3araht/bandominedoni/pictures/20210606_bandominedoni_FN_layer.png

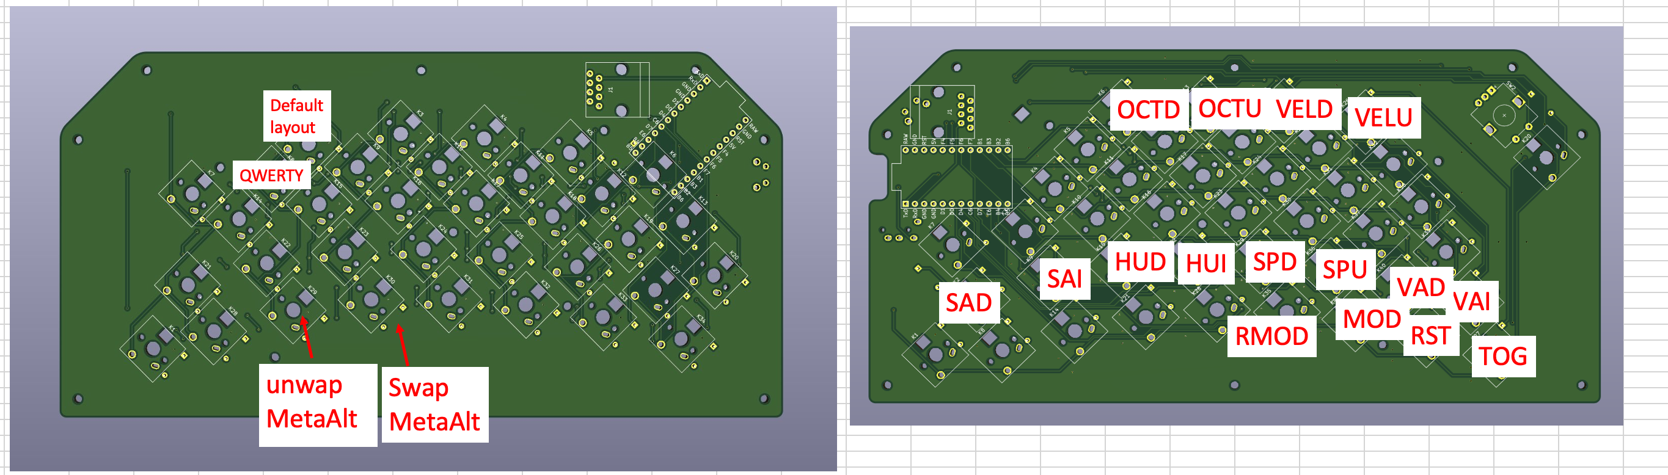
pictures/20210606_bandominedoni_FN_layer.png
