3araht/bandominedoni/pictures/keymap_cheatsheet_bandominedoni.png

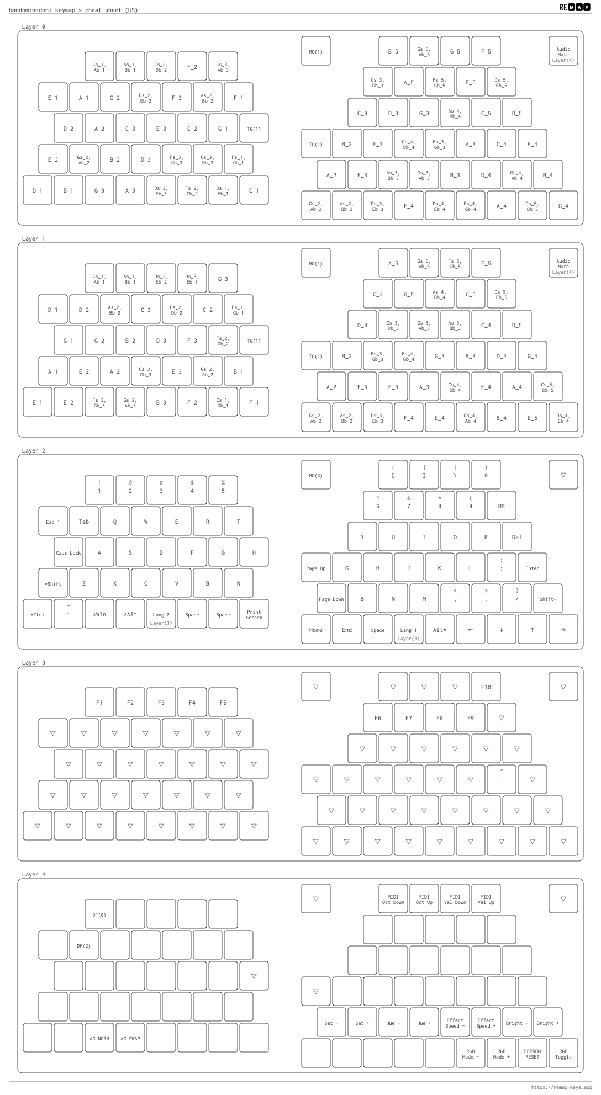
pictures/keymap_cheatsheet_bandominedoni.png
