3araht/bandominedoni/pictures/new_keyboard_bandominedoni.jpg

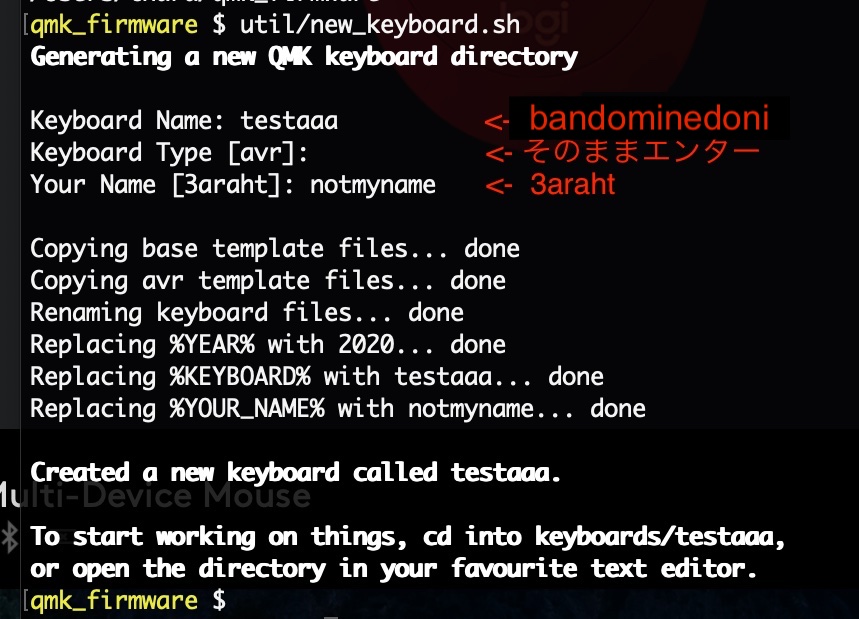
pictures/new_keyboard_bandominedoni.jpg
