3araht/bandominedoni/docs/build.md

# bandoMIneDonI Build Guide

**一度すべて読んでから組み立てることをお勧めします。**

## 0 ##
## パーツの確認、各部品の実装面の整理 ###
### キット付属品

| パーツ名 |  個数  |  備考  |
|---|---|---|
|基板|2枚||
|ボトムプレート|2枚||
|M2 スペーサー |26個||
|M2 ネジ|52個||
|クッションシール|10個||
|リセットスイッチ|2個|ファームウェアを書き込むときに使います。|
|ダイオード 1N4148|76個|左手側 33鍵 + 1鍵 + 右手側38鍵 + 2鍵 + 2（開閉ペダル用＋機能切り替えボタン用 )|
|TRRS コネクタ|1個|開閉ペダル接続用|
|LAN コネクタ|2個|左右キーボード接続用|

### 別途用意いただく必要のあるもの

| パーツ名 |  個数  |  備考  |
|---|---|---|
|[Pro Micro （コンスルー付き）](https://yushakobo.jp/shop/promicro-spring-pinheader/)|2個|ファームウェア なし をお選びください（別途書き込みます）。|
|Kailh mid-height スイッチ|71 〜75個|Cherry MX系は使えません！！！|
|13 mm 角のキーキャップ|71〜75個|（Cherry MXと同じステムなのですが、普通の1Uサイズのキーキャップは隣接するキーキャップと干渉してしまうため、使えません！！！）デモ機では、nekoka さんの「OYKキーキャップ1Ux80個(MidHeightスイッチ 13x13mmキーピッチ用)　https://make.dmm.com/item/1317194/ 」を使っています。|
|MicroUSBケーブル|1本|Pro Micro 側のコネクタの耐久性が低いためマグネット式を推奨。Pro Micro にファームウェア書き込むときにとても便利です。また、データ通信ができるケーブルである必要がありますので、充電用のケーブルは使えません。Hex ファイルが書き込みできなかったらケーブルを確認してみてください。|
|LANケーブル|1本|左右のキーボード接続用に使います。細身タイプがおすすめ。|

### [Optional]別途用意いただく必要のあるもの

| パーツ名 |  個数  |  備考  |
|---|---|---|
|LED: SK6812mini-E|1個 or 76個|内訳：開閉ペダル用 1 個だけ光らせる場合、もしくは、全てのLEDを光らせる場合は上に加えて音階キー33 + 38 個+追加ボタン（左側1個＋右側2個。LEDのデータ伝送の都合上、追加ボタンを使わない場合でも実装する必要があります）+ 機能切り替えボタン 1 個|
|[ロータリーエンコーダ(ノブ付き)](https://yushakobo.jp/shop/pec12r-4222f-s0024/)|1個|[押しボタンがないタイプ](https://akizukidenshi.com/catalog/goods/search.aspx?search=x&keyword=EC12E24)の場合、ロータリーエンコーダーの下にキースイッチを付けることで、押しボタン機能部分の代用が可能です。ロータリーエンコーダーがなくても、このキースイッチを付けることでミュートON/OFF、長押しでモード切り替えが可能です。なお、実装可能なロータリーエンコーダーは EC11 EC12 の2タイプです。|
|サスティンペダル|1台|サスティンペダルを使わなかった場合を想定し、その時をOpen状態（蛇腹を広げた時の状態）にするため、デフォルトはノーマリオフタイプ（KORG）を想定しています。ソースを1行書き換えることでノーマリーオンタイプ（主にYAMAHA、ROLAND）にも対応します。 極性切り替えタイプのペダルもあるのでそちらをおすすめします。|
|3.5 mm ミニジャック変換ケーブル|1本|サスティンペダルのモノラルジャックを TRRS コネクタに刺さるように変換します。|

### オモテ面、裏面の実装物

**※ 部品の実装には順番があります。特に、Pro Micro、キースイッチ、エンコーダ、の実装は最後になりますので先に実装しないよう注意ください。
実装の順番はこの後の手順に従ってください。**

右手側 オモテ面<br>
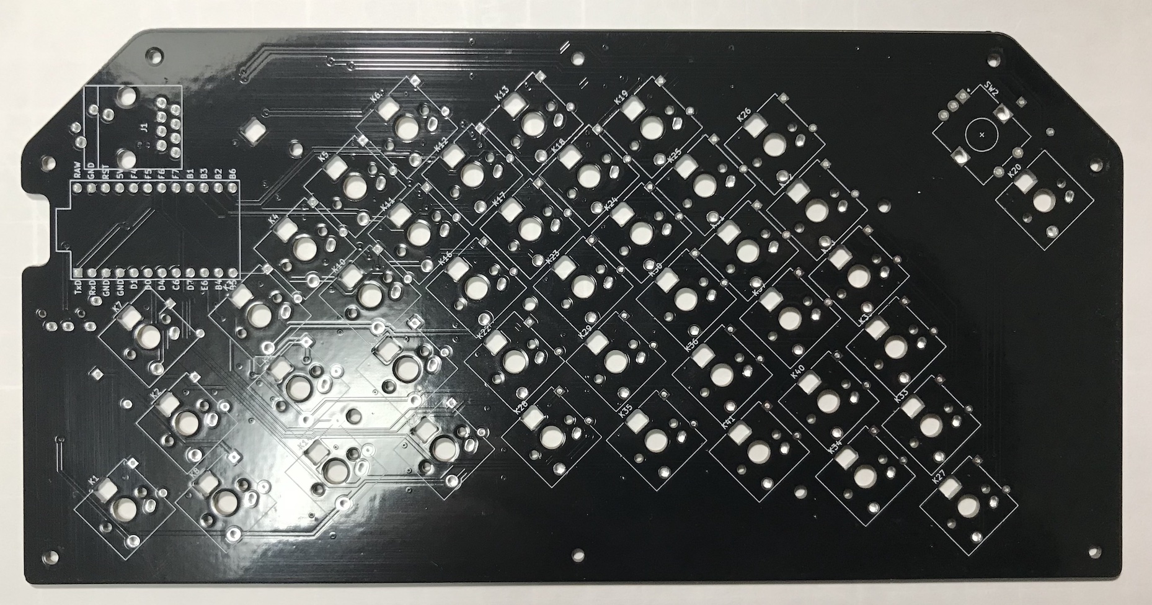
[picture p6: pictures/right_pcb_front_r02.jpg]


右手側 裏面<br>
基板の裏面には、ダイオードの実装場所やキーボード名が印字されています。<br>
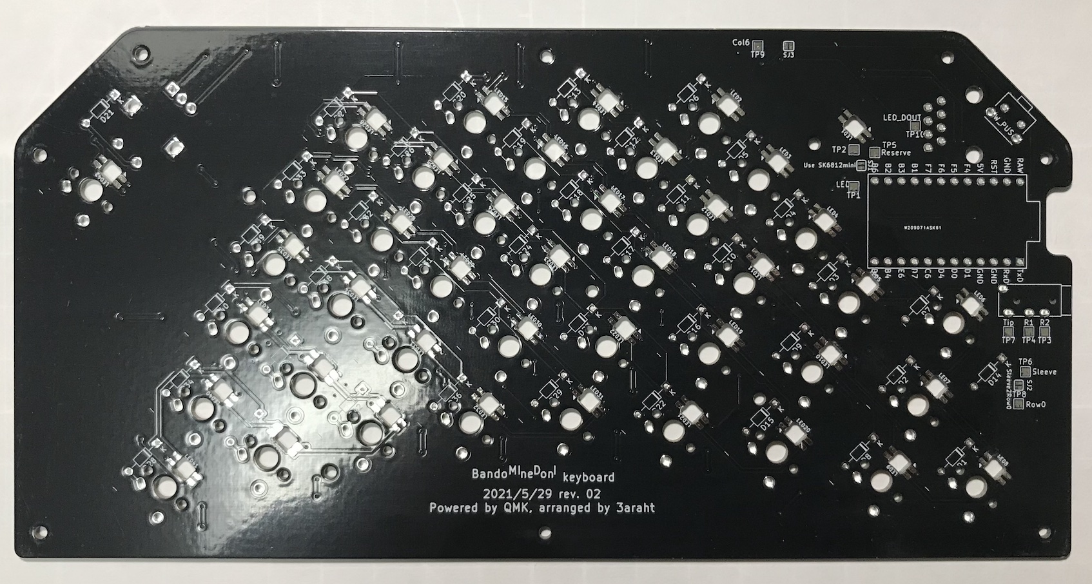
[picture p7: pictures/right_pcb_rear_r02.jpg]


左手側 オモテ面<br>
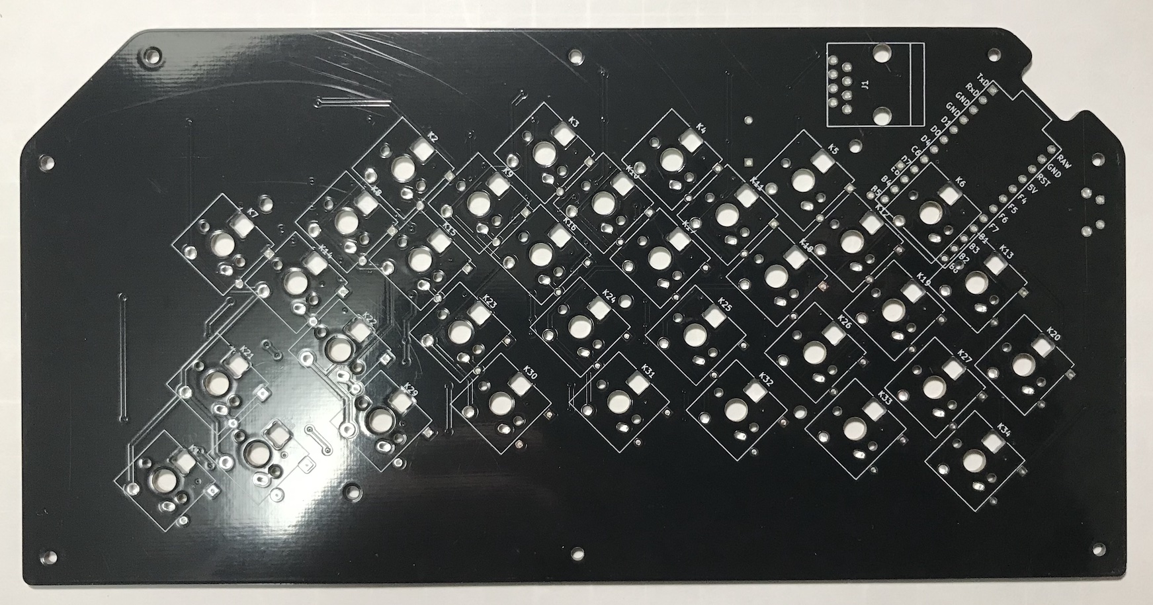
[picture p8: pictures/left_pcb_front_r01.jpg]


左手側 裏面<br>
基板の裏面には、ダイオードの実装場所やキーボード名が印字されています。<br>
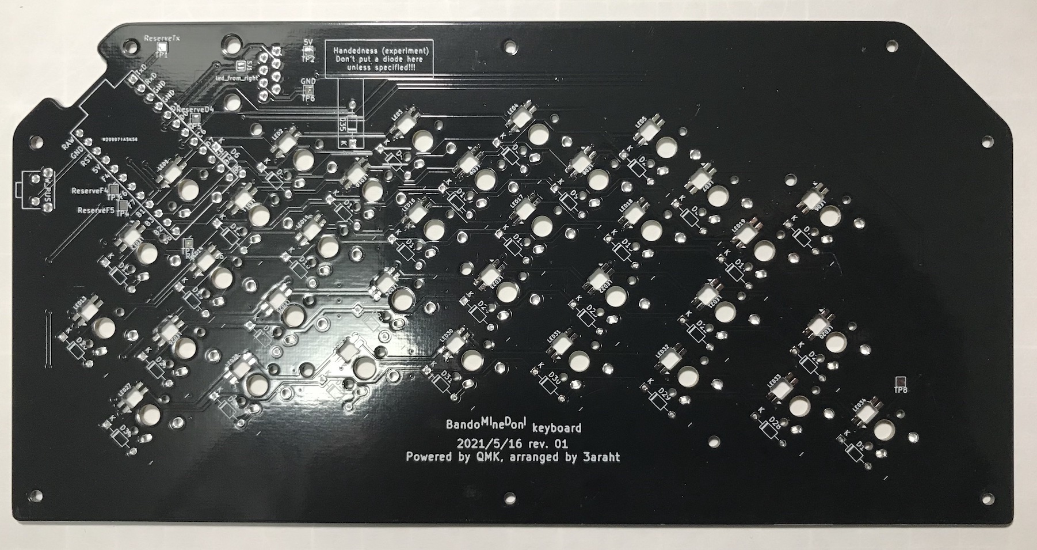
[picture p9: pictures/left_pcb_rear_r01.jpg]


#### 裏面には次の部品を実装します
 - ダイオード
 - リセットスイッチ
 - Pro Micro
 - TRRS コネクタ
 - LED[Optional]

#### オモテ面には次の部品を実装します
 - キースイッチ
 - LAN コネクタ
 - エンコーダ

## 1
## ダイオードの取付け ##
キーの数が多いキーボードではMatrixという手法を使ってキーが押されたかどうか判断します。
キーが必ず1個ずつしか押されないと保証されているのであれば、このダイオードは不要なのですが、
和音を弾くことがあるので複数のキーを同時に押す場面が出てきます。
このとき、Matrixという手法で複数同時押しを正しく判断するためにこのダイオードが必要になります。
詳しい説明については、[こちら](https://docs.qmk.fm/#/how_a_matrix_works)などをご覧ください。

ダイオードには向きがあります。また、図のように足を曲げておきます。
ダイオードをつまんで両端の足を同時に曲げると図の右のように比較的ちょうどいい形になります。<br>
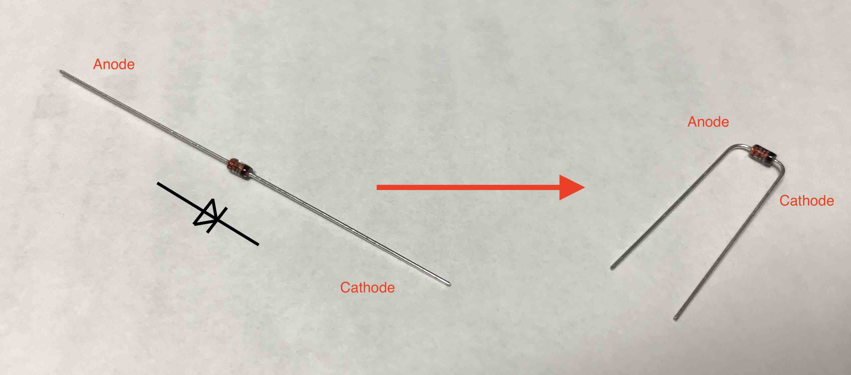
[picture p10: pictures/diode_bend.jpg]
diode


キースイッチと干渉しないように、ダイオードは基板の裏面に実装します。
ダイオードの黒い線のほうが四角いフットプリント（Kと印字されている方, K はKathode（独）の頭文字らしいですが、黒（Kuro) の K で。）に合うように配置します。<br>
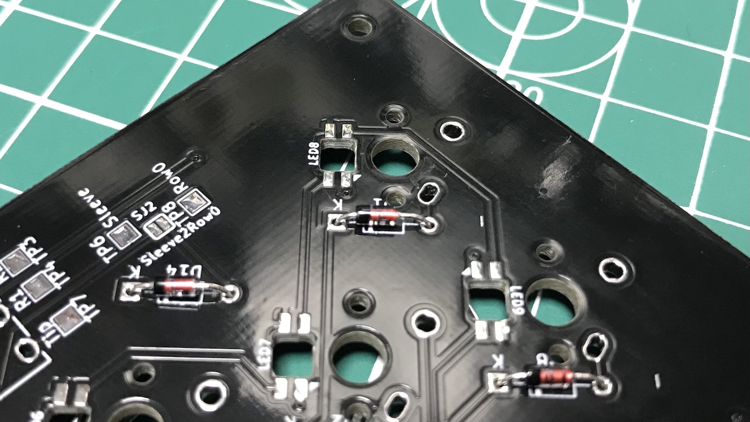
[picture p11: pictures/diode_align.jpg]
diode


足を曲げて基板に這わせてダイオードを仮止めします。<br>
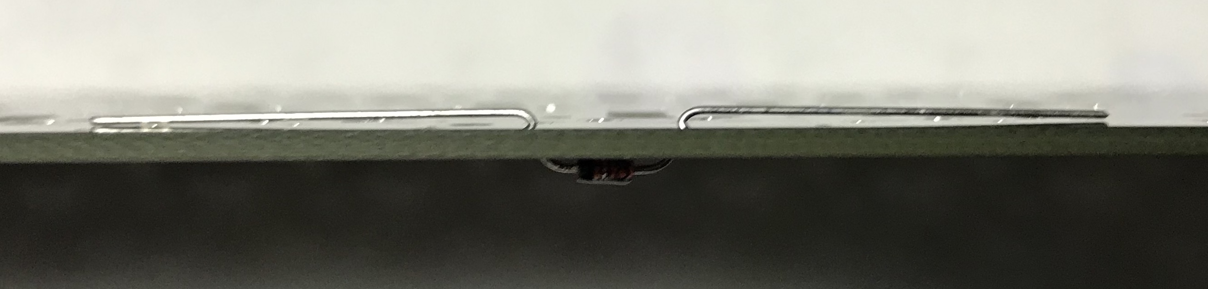
[picture p12: pictures/diode_flatten.jpg]
diode


オモテ面から見た図<br>
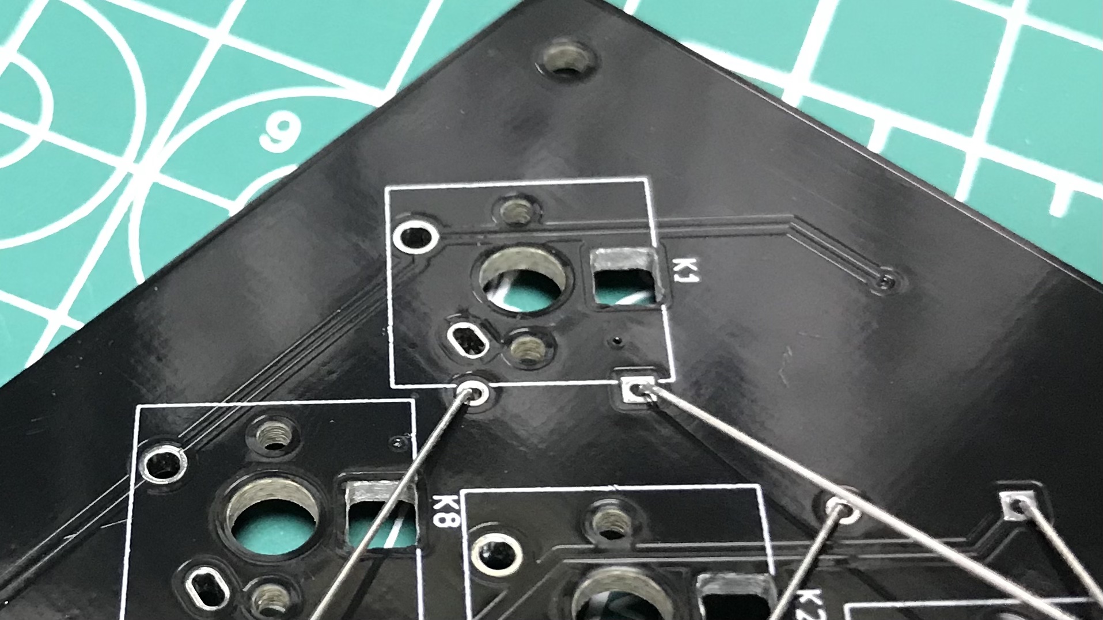
[picture p13: pictures/diode_flatten2.jpg]
diode


オモテ面から半田付けします(あ、ピンボケ。。。)。<br>
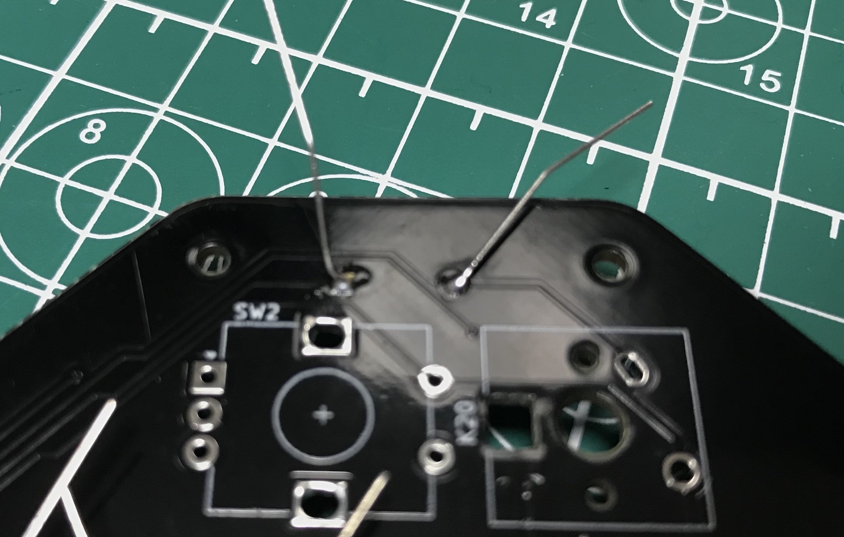
[picture p14: pictures/diode_soldered.jpg]
diode


足をニッパでカットします。足は勢いよく飛んで行くので、足を押さえながら切ると良いです。<br>
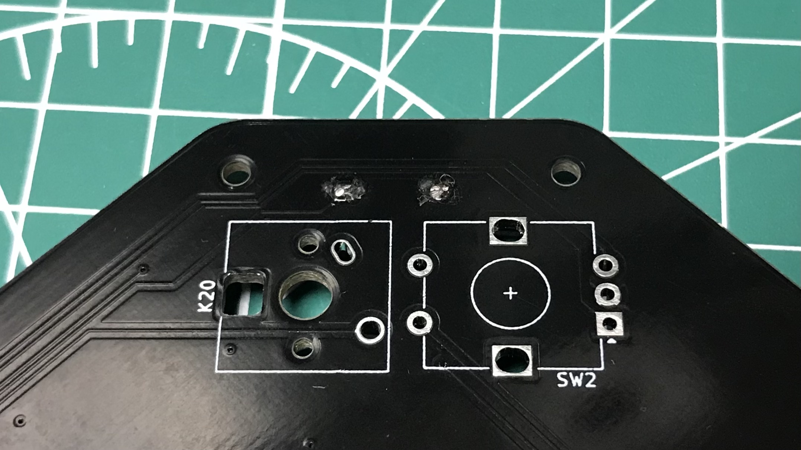
[picture p15: pictures/diode_feet_cut.jpg]
diode


これを右手側は D01 〜 D42 の42箇所、左手側は D01 〜 D34 の34箇所、半田付けします。<br>

~~左手側基板の D35 にもダイオードを実装します。このダイオードは、右手側基板か左手側基板かを Pro Micro が判断するのに用います。~~<br>
ケーブルをゆっくり接続する分にはよかったのですが、素早く抜き差しをすると、右手側基板が間違って左手側と誤認識することがしばしば発生しました。そのため、この機能を使うのはやめました。MASTER_RIGHT を定義したので、USBケーブルが刺さっている方を右手側基板と認識します。<br>
⇨ 左手基板の D35 は実装不要です。<br>
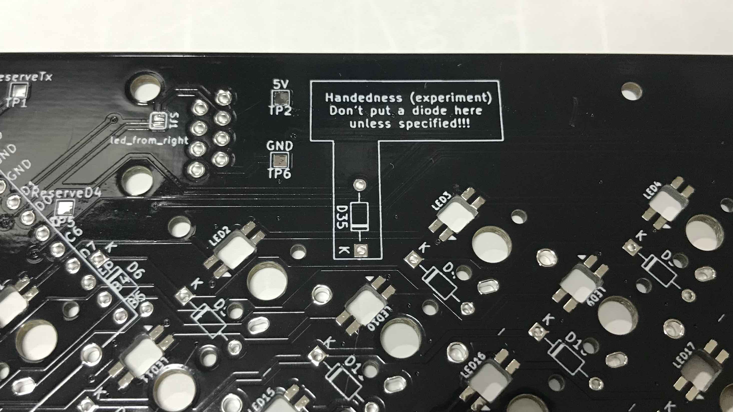
[picture p16: pictures/handedness.jpg]


## 2 ##
## リセットスイッチ、TRRS コネクタの取り付け ##
白い四角い枠のシルクに沿って裏側に取り付けます。浮いたり曲がった状態で実装しないようにマスキングテープなどで予め仮止めしてから半田付けするとミスが少なくなります。<br>

TRRS コネクタを図のように実装します。<br>
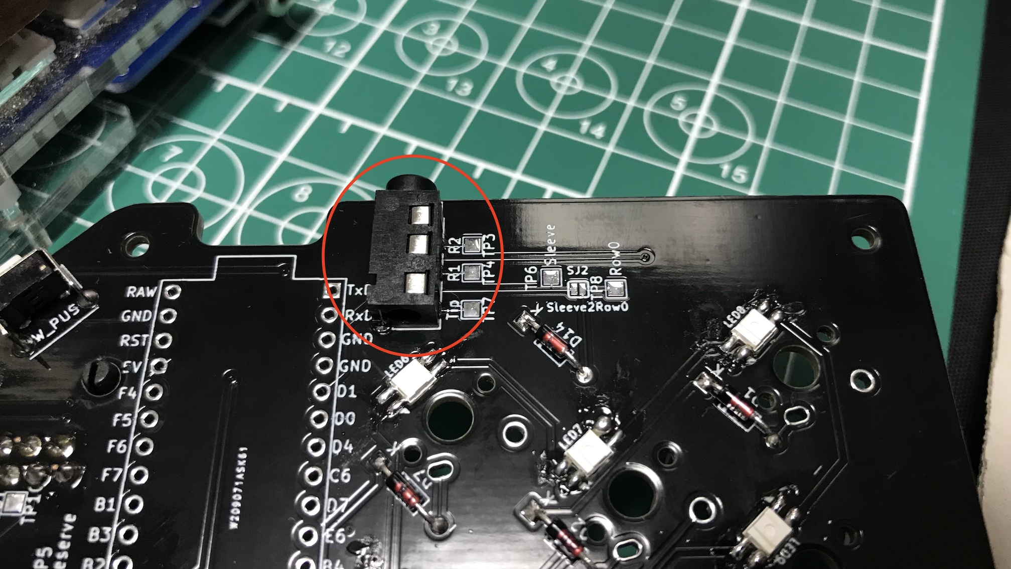
[picture p17: pictures/TRRS_RESETsw_soldering.jpg]
TRRS
<br>

また、ジャンパー2箇所に半田を盛って導通するようにします。<br>
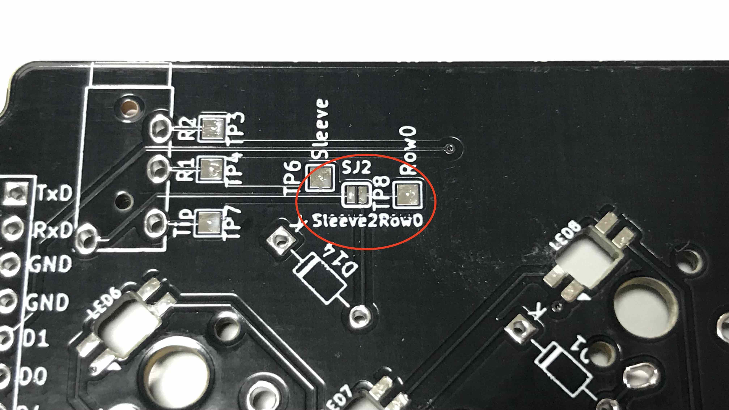
[picture p18: pictures/right_jumper_SJ2.jpg]
<br>
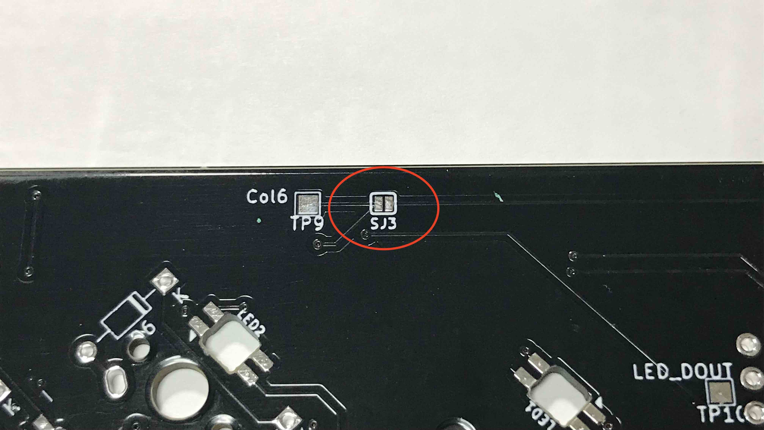
[picture p19: pictures/right_jumper_SJ3.jpg]
<br>

右手側のリセットボタンの足が、あとで実装する LAN コネクタと干渉するため、リセットボタンの足を切ってから半田付けします。<br>
※ rev.04 の基板ではこの問題は解消していますので、3、へ進んでください。<br>

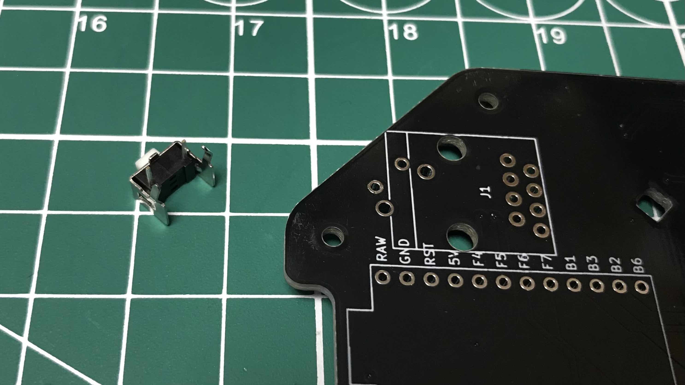
[picture p20: pictures/RESETsw_soldering_right1.jpg]
ResetSW
<br>
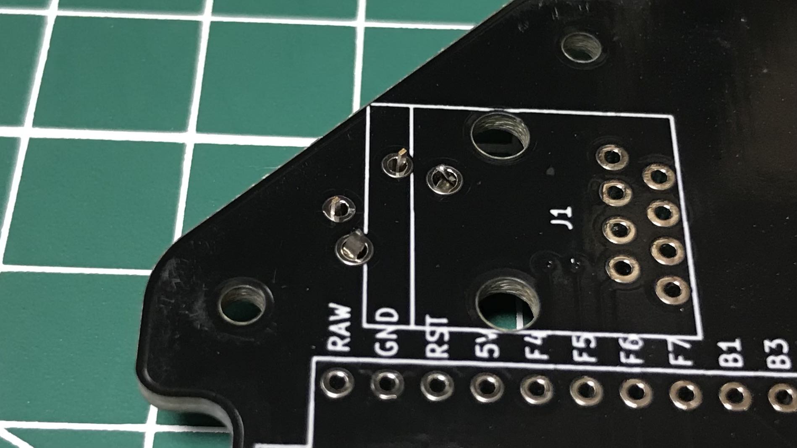
[picture p21: pictures/RESETsw_soldering_right2.jpg]
ResetSW
<br>
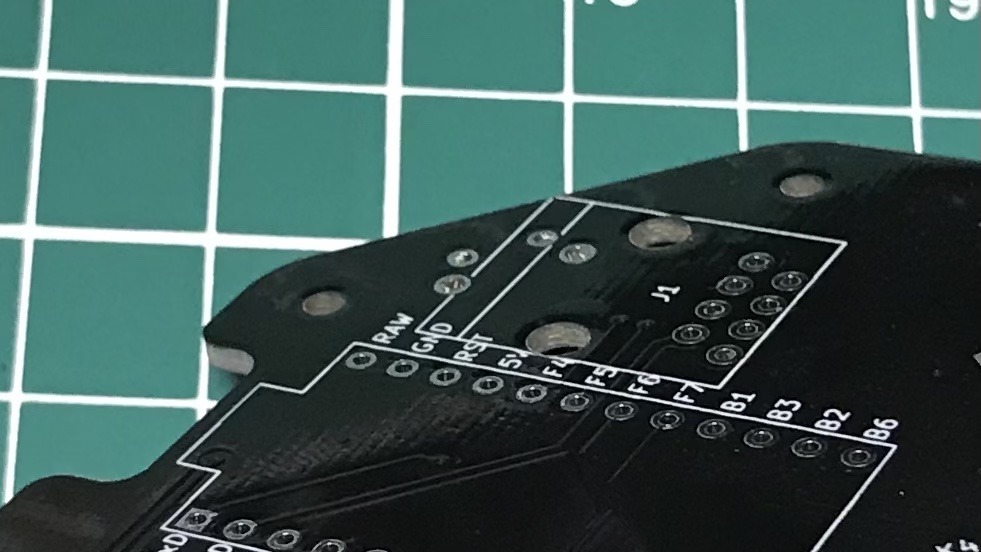
[picture p22: pictures/RESETsw_soldering_right3.jpg]
ResetSW
<br>

左手側基板のリセットスイッチも裏面に実装します。
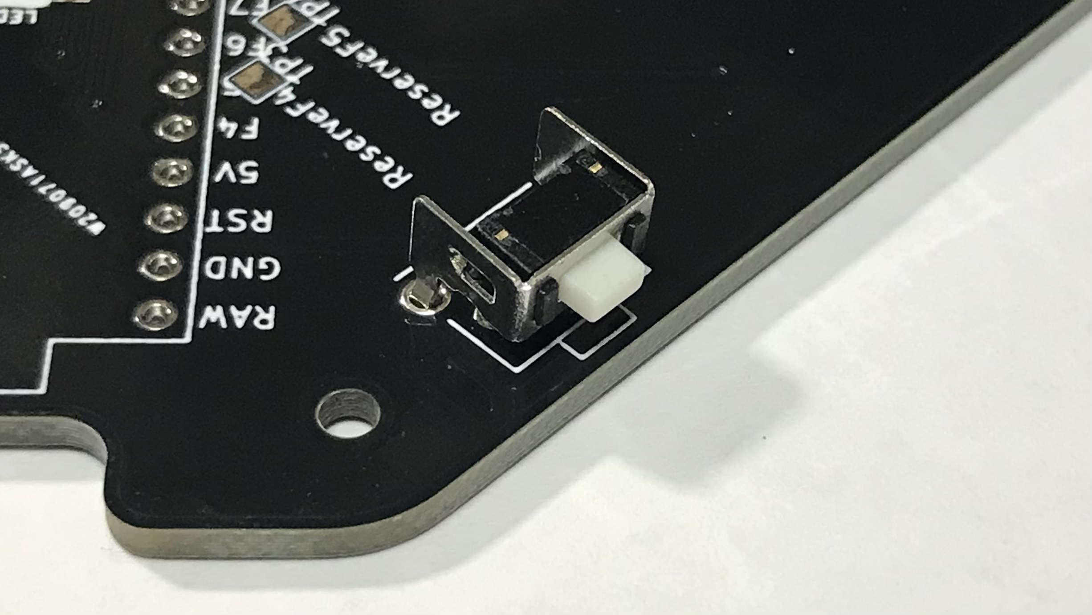
[picture p23: pictures/RESETsw_soldering_left.jpg]
ResetSW
<br>

## 3 ##
## LANコネクタの取付け ##
左右の基板のオモテ面にそれぞれLANコネクタを実装します。<br>
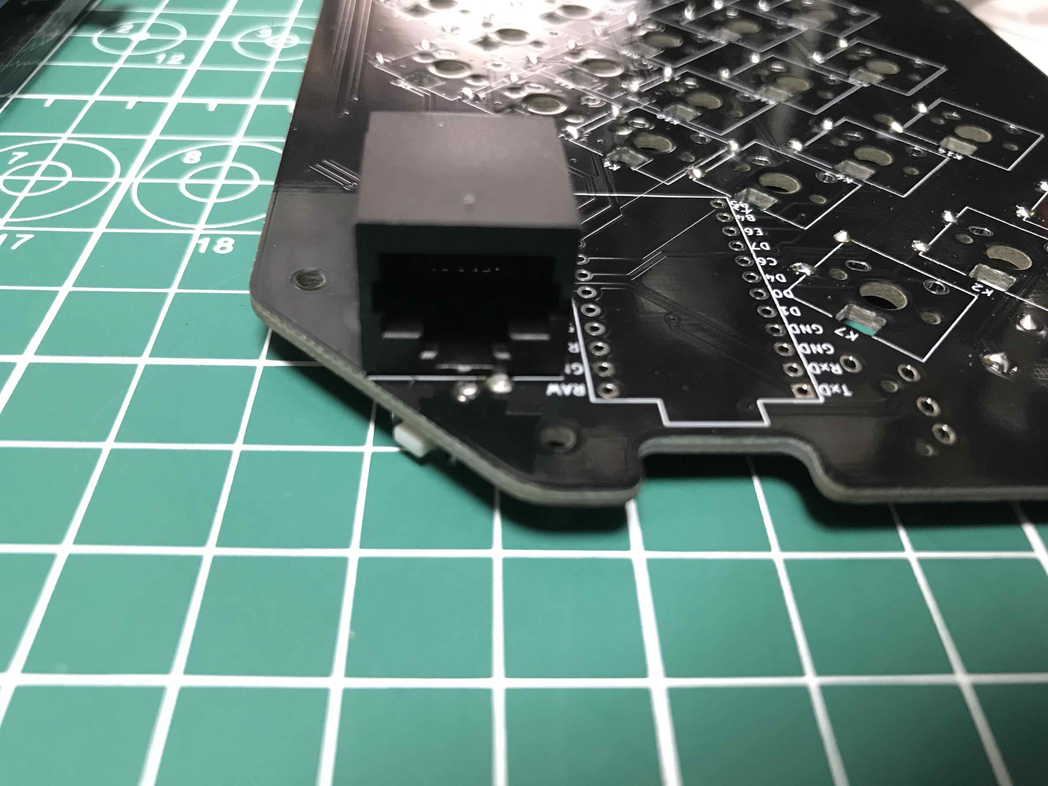
[picture p24: pictures/LAN_connector.jpg]
<br>

## 4 ##
## Pro Micro の仮り取付け ##
**ここでは Pro Micro をコンスルー（別名 スプリングピンヘッダー ＝ Pro Micro を基板から着脱可能にするコネクタ）を使うことを前提とし、コンスルーと Pro Micro を半田付けして Pro Micro にファームウェアを書き込みます。あとで Pro Micro を取り外す必要がありますので、（おすすめしませんが）コンスルーを使われない方はキースイッチ実装したあとでProMicroを実装してください。**

※コンスルーを使う場合は Pro Micro 側のみを半田付けします。<br>
コンスルーの役割： 基板側を半田付けしないことにより、 Pro Micro を基板から外せるようにします。
これにより、万が一 Pro Micro の microUSB コネクタがもげても交換が容易になります。<br>

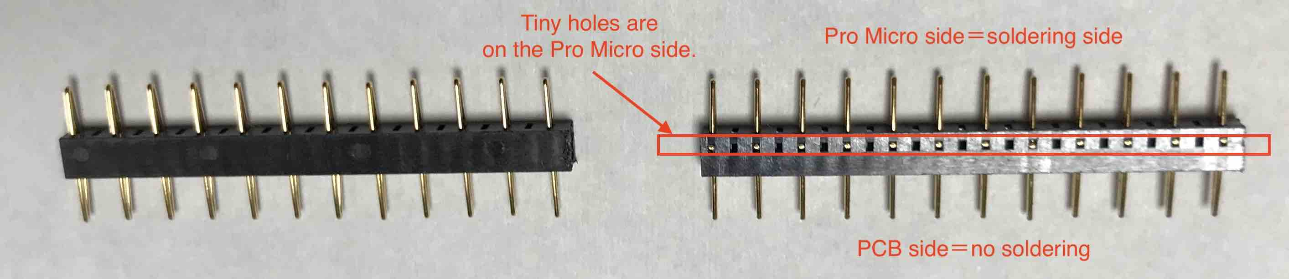
[picture p25: pictures/Con_through.jpg]


コンスルーを斜めに半田付けしないように、基板の**裏面から**コンスルーを差しておいてピンが垂直になるようにします。
下図のように、Pro Micro 側(側面に空いている小さな穴が近い方)を上にして基板にコンスルーを差し込みます。
このとき、図のように、コンスルーの向きを揃えておきます（＝2つとも側面の小さな穴が空いている方向を揃えます）。<br>
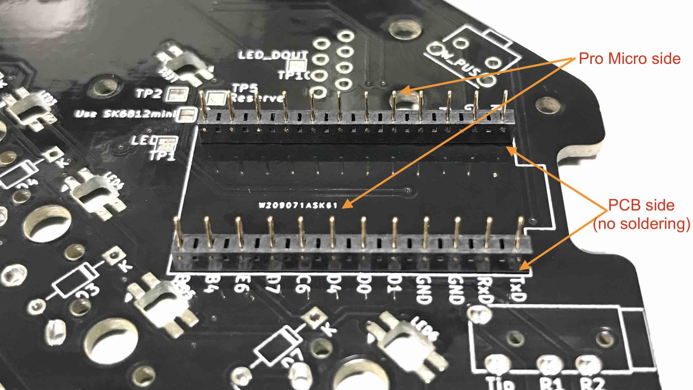
[picture p26: pictures/Con_through_onPCB.jpg]


*Pro Micro の上下の向きに注意。Pro Micro の TxD ピンが基板の TxD に刺さるように向きが合っているか確認します。<br>
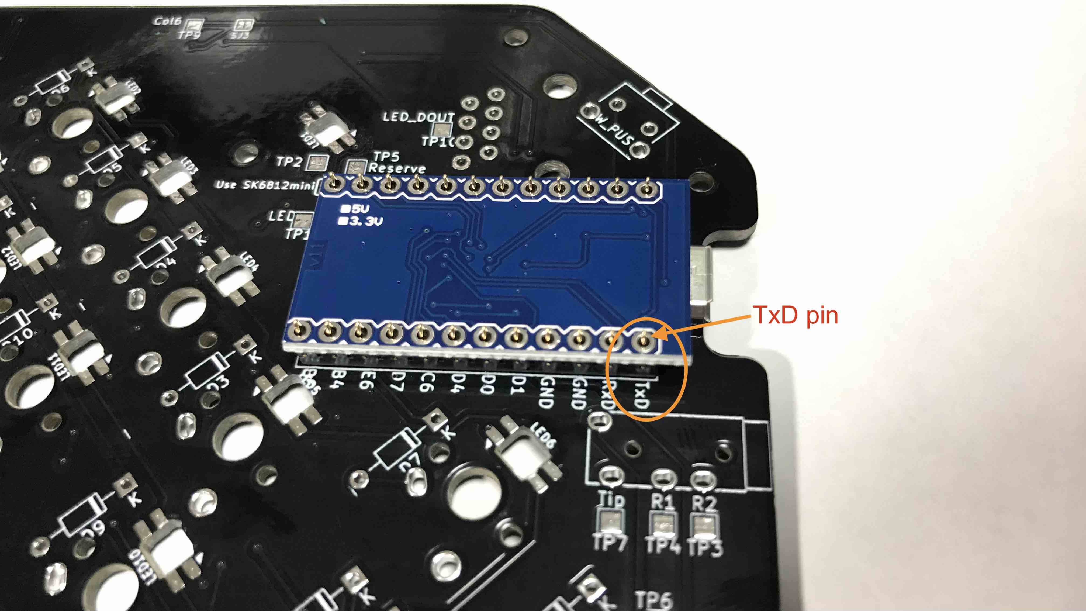
[picture p27: pictures/ProMicroPinAlignment.jpg]
<br>

コンスルーを基板の裏面から差し、TxD の位置を見て向きが揃っていることを確認したら、コンスルーと Pro Micro を半田付けします。<br>
**Pro Micro が浮きやすいので、Pro Micro をしっかり押さえながら最初に四隅を半田付けすると作業が楽になります。**<br>
**一度半田付けしたコンスルーを外すのは困難を極めますので、十分注意してください。**

コンスルーを Pro Micro に実装した様子<br>
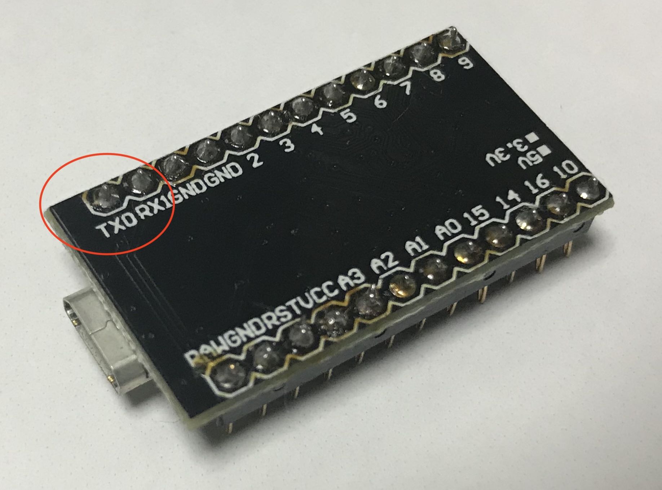
[picture p28: pictures/ProMicro_TxD_r02.jpg]
<br>
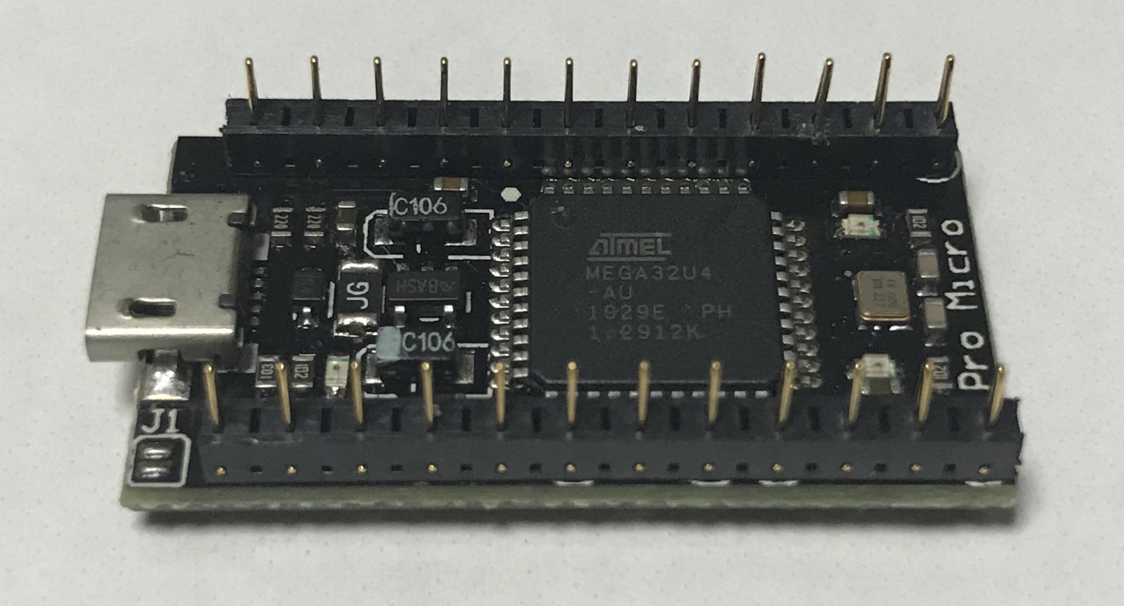
[picture p29: pictures/ProMicro_front_r02.jpg]
<br>

### (2021/06/27 追記) ProMicro を基板に実装する際に、コネクタ部を絶縁します。

これは、コネクタ部が基板と当たり、使っているうちに擦れて基板のレジストに穴が空き、そこからショートしてしまった場合に電源が入らなくなる、という問題を回避するためです( chromatonemini で発生しました)。<br>
（下に紹介する写真は chromatonemini のものになります。ご了承ください。）<br>
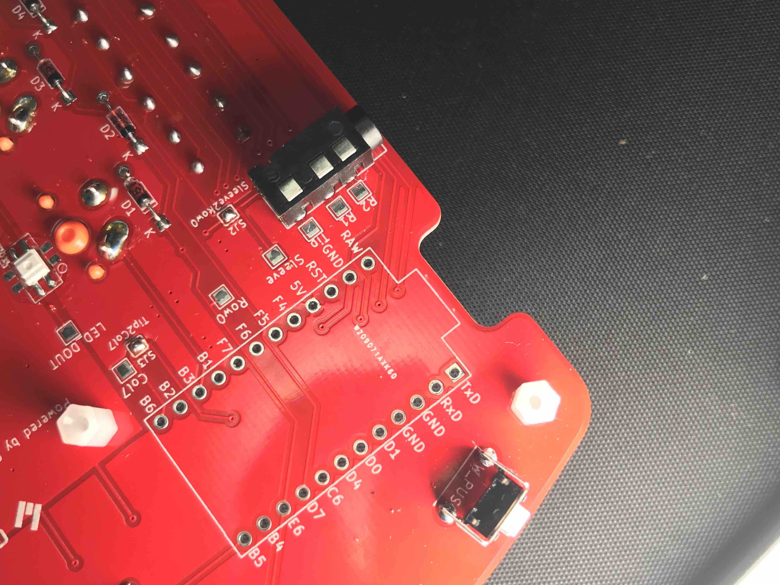
[picture p30: pictures/SnakeBite_failure.jpg]
SnakeBite
<br>

このように、スネークバイトのような跡がつき、そこからProMicro のコネクタと基板の 5V がショートしてしまっていました。<br>
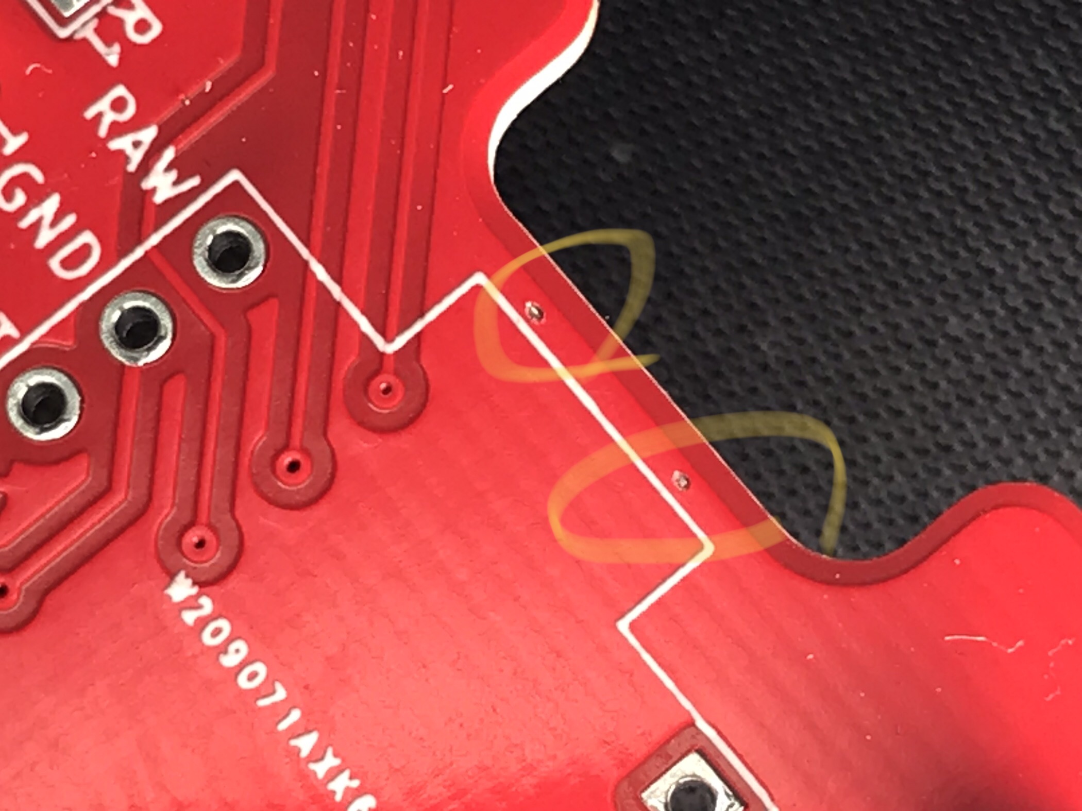
[picture p31: pictures/SnakeBite.jpg]
SnakeBite
<br>

基板にカプトンテープを貼って絶縁します。<br>
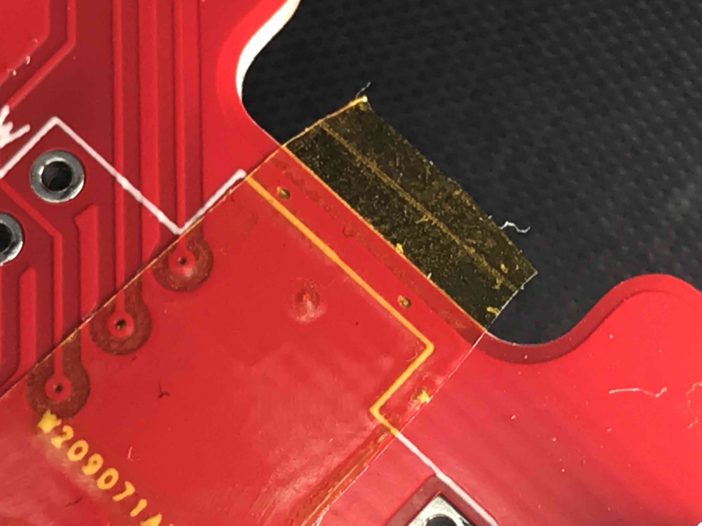
[picture p32: pictures/SnakeBiteInsulated.jpg]
SnakeBite
<br>

ProMicro の方にもカプトンテープを貼って絶縁します。<br>
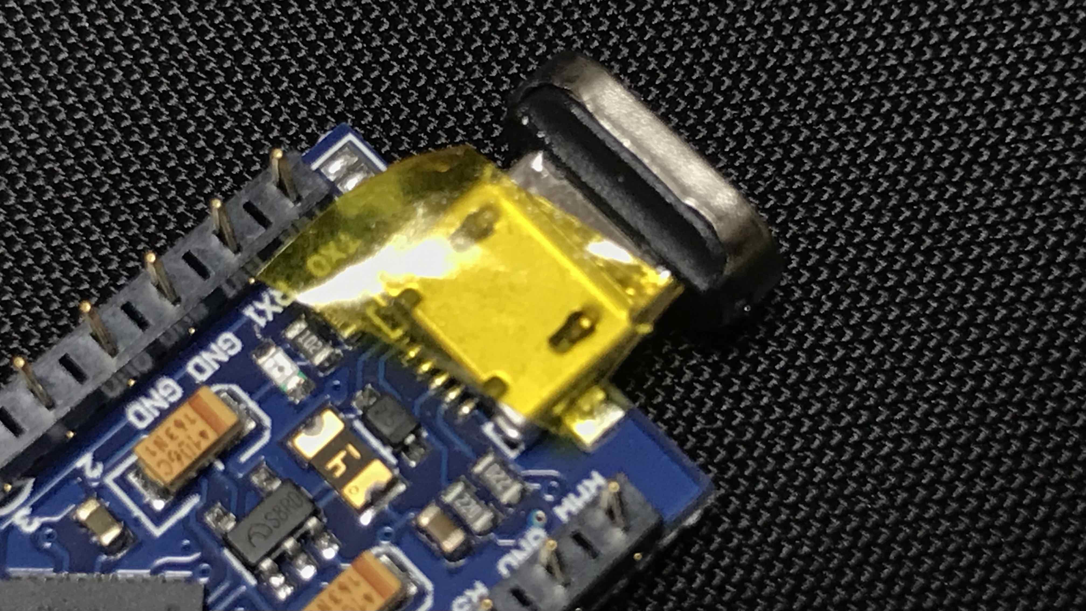
[picture p33: pictures/ProMicroInsulated.jpg]
<br>

## 5 ##
## Firmwareの書き込み ##
とりあえず動作確認用にファームを書き込みます。
LEDが光るHEXファイル(bandominedoni_led.hex)を使います。<br>

Remap を使うととても簡単に Promicro にファームウェアを書き込むことが可能です。

Remap Catalog から、 bandominedoni キーボードを探します。<br>
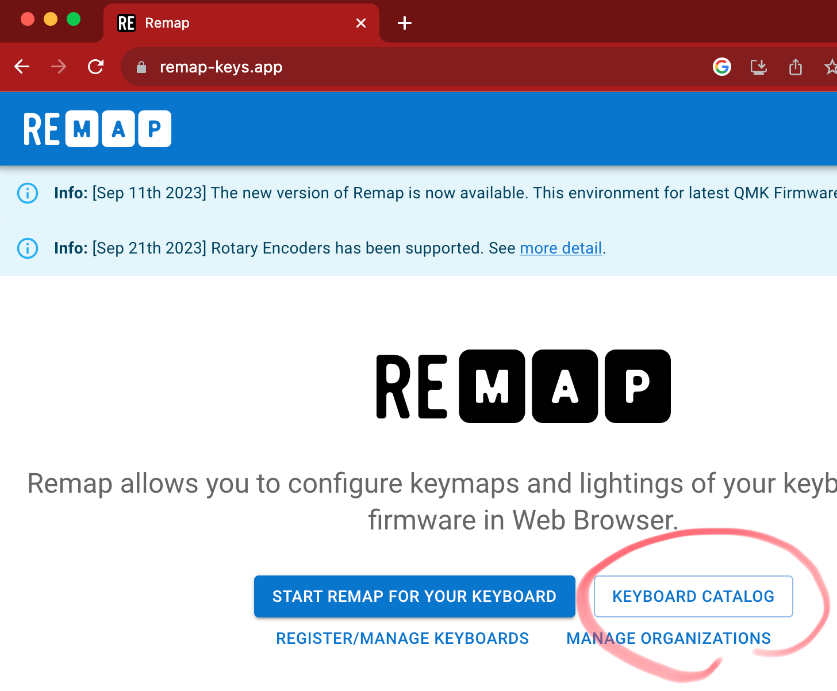
[picture p34: pictures/RemapKeyboardCatalog.png]
RemapKeyboardCatalog
<br>

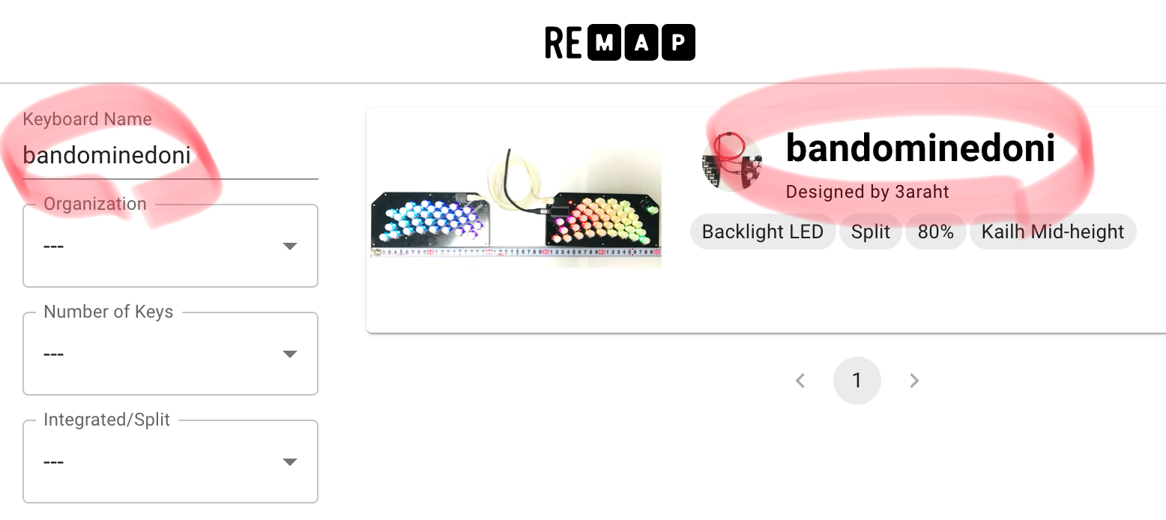
[picture p35: pictures/Remap_bandominedoni.png]
Remap_bandominedoni
<br>

書き込むファームウェアを選択します。<br>
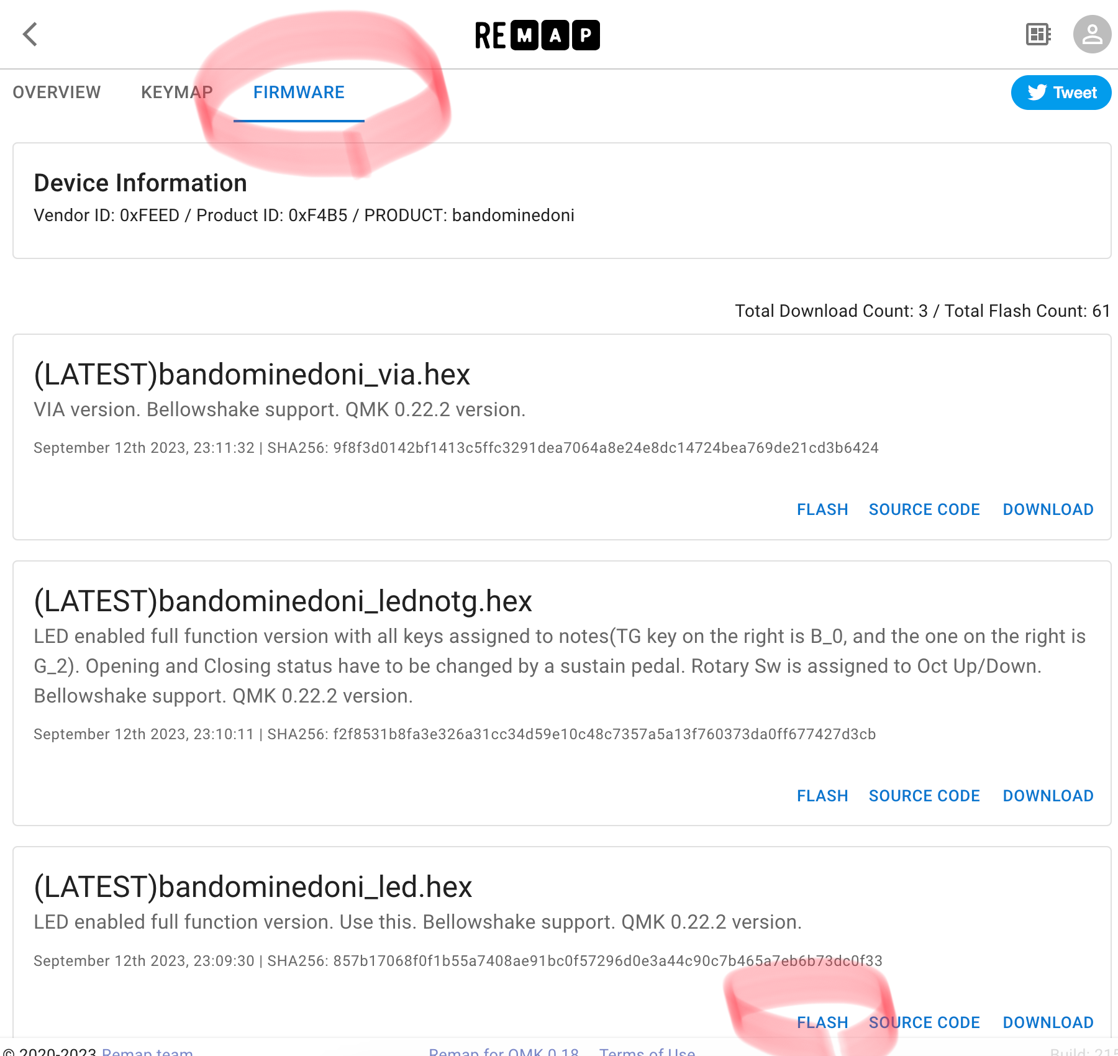
[picture p36: pictures/RemapFirmwareSelect.png]
RemapFirmwareSelect
<br>

Elite-C をお使いの場合は bootloader として dfu を、それ以外の場合は caterina を選択してファームウェアを書き込みます。書き込み方の詳細は画面に示されている手順に従ってください。<br>
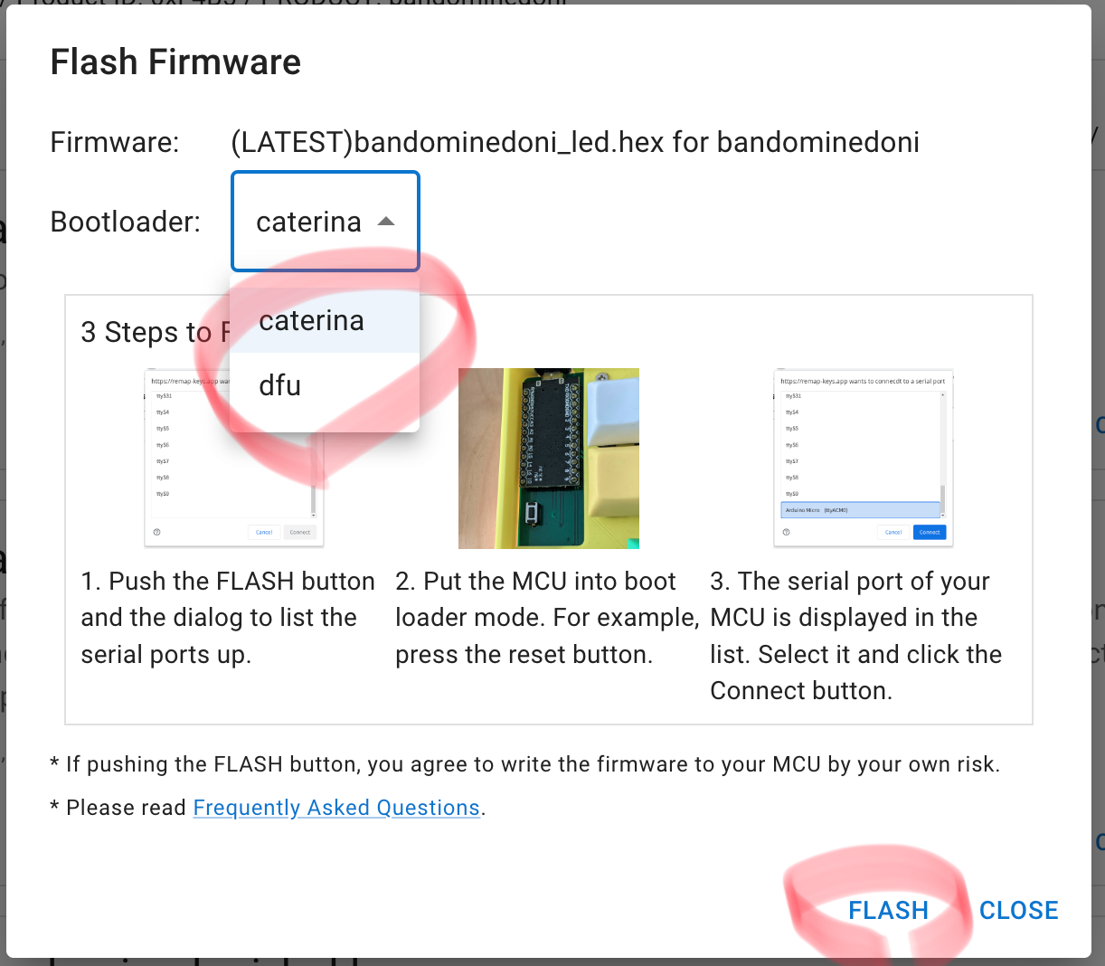
[picture p37: pictures/RemapFlash.png]
RemapFlash
<br>

他の書き込み方も色々あります。サリチル酸さんの[記事](https://salicylic-acid3.hatenablog.com/entry/qmk-toolbox)がとても参考になります(サリチル酸さん、どうもありがとうございます)。

## 6 ##
## Backlight RGB LEDの取付け[Optional] ##
以下を使うことが成功の鍵となります。<br>
- 温度調整機能付き半田ごてで温度を220℃〜250℃に設定する
- 融点の低い 鉛入り半田（共晶半田）を使う
- 電源ラインはランドが広く熱を奪われてしまうので、しっかり基板側を温める。
- 数珠繋ぎのLEDを順番に実装して光るか確認しながらすこしずつ進める。LED は 5V と GND の電源ラインに並列に実装するため、どれか1つが壊れているときにどこが壊れているかを特定するのが難しいです。⇨ 一気に全部 LED を実装しない。

バックライト用のチップ LED(SK6812mini-E) は PCB の裏面から実装します。向きに注意して穴に入れてください。
LED の裏から見て、切り欠きのある端子（GND）と基板のシルク（印字の事）の三角マークが同じ位置になります。
LED はデータを直列に伝送する都合上、行によって LED の向きが異なります。<br>
LEDの情報は直列に伝送されますので、接続が途切れてしまうと正しくLEDが光らなくなります。<br>
左手側の基板は、右手側からの電源供給およびデータ線の信号が無いと動作しませんので、左手側のLEDの動作確認をする場合にはLANケーブルを接続して、右手側の基板のPro Micro にUSBケーブルを接続してください。<br>
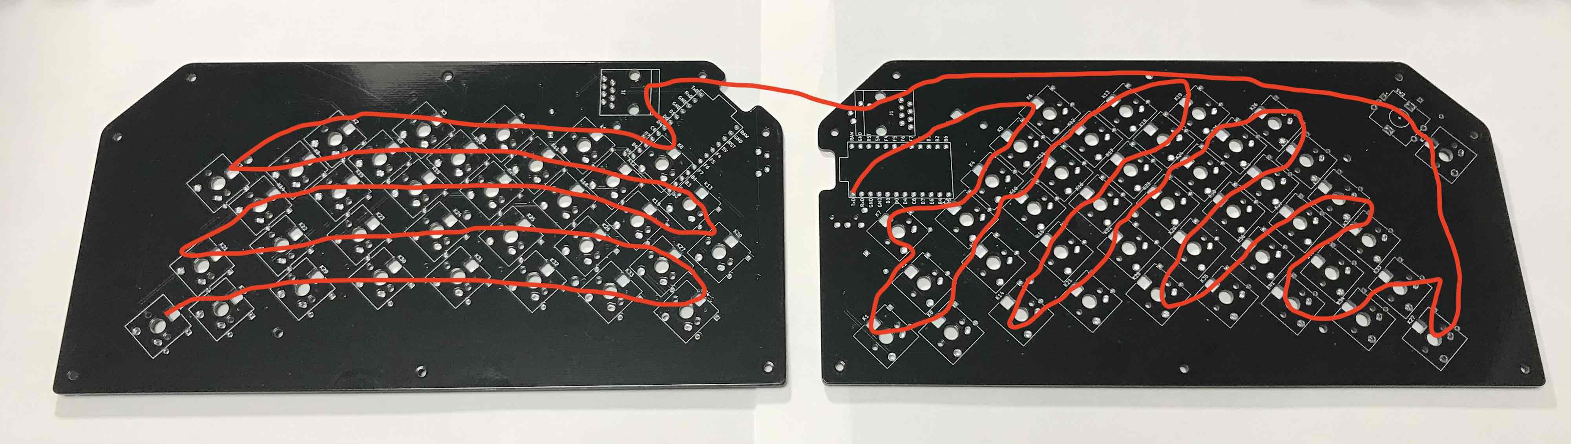
[picture p38: pictures/LED_serial.jpg]


半田付けが軌道に乗った矢先に向きを間違えがちです。
その時のショックと言ったら。。。（経験者談）。<br>
LED を穴にいれたら、端子の上に半田を盛って半田付けしていきます。このとき、基板とLEDの足の裏に半田を入れようと意識する必要はありません。基板のランドの方が LED の足よりもひとまわり大きいので、そこが半田付けされるイメージで実装していってください。<br>
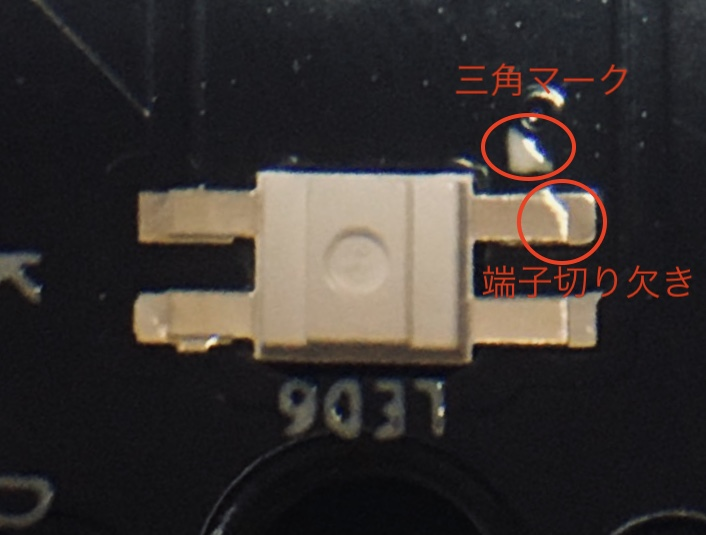
[picture p39: pictures/LED_PIN_Layout.jpg]


半田付けしてしまうと、端子の切り欠きは見えなくなります。実装後は、オモテ面から、パッケージの切り欠きをご確認ください。<br>
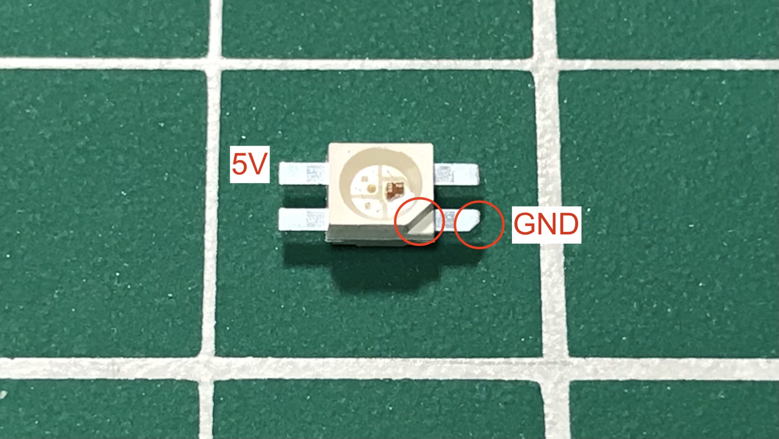
[picture p40: pictures/SK6812mini-E.jpg]


温調半田ごてを使い、約220℃ 〜 250℃ で半田付けします。温度が高いとLEDが壊れますので注意してください。
温調できない半田ごてではすぐに焦げます＆壊れます（これも経験者談）。逆に、温度調節をしていれば、LEDを熱で殺すことはほとんど無いので、ご安心ください。<br>

右手側基板の下図の位置を半田でジャンパします。<br>
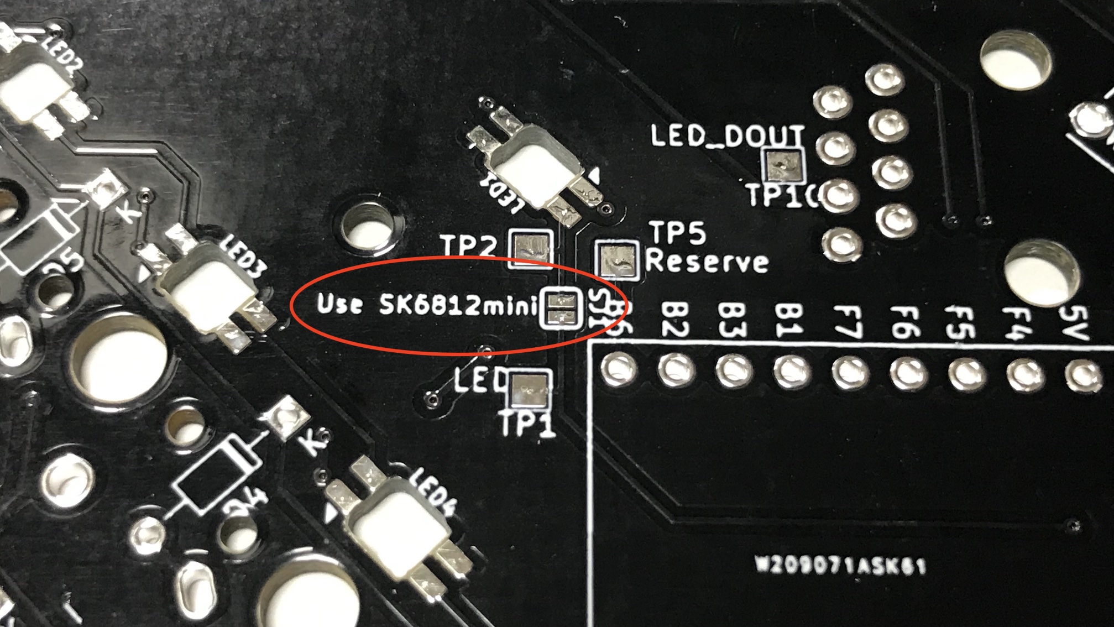
[picture p41: pictures/jumper_right_LED.jpg]
Jumper
<br>

左手側基板はここを半田でジャンパします。<br>
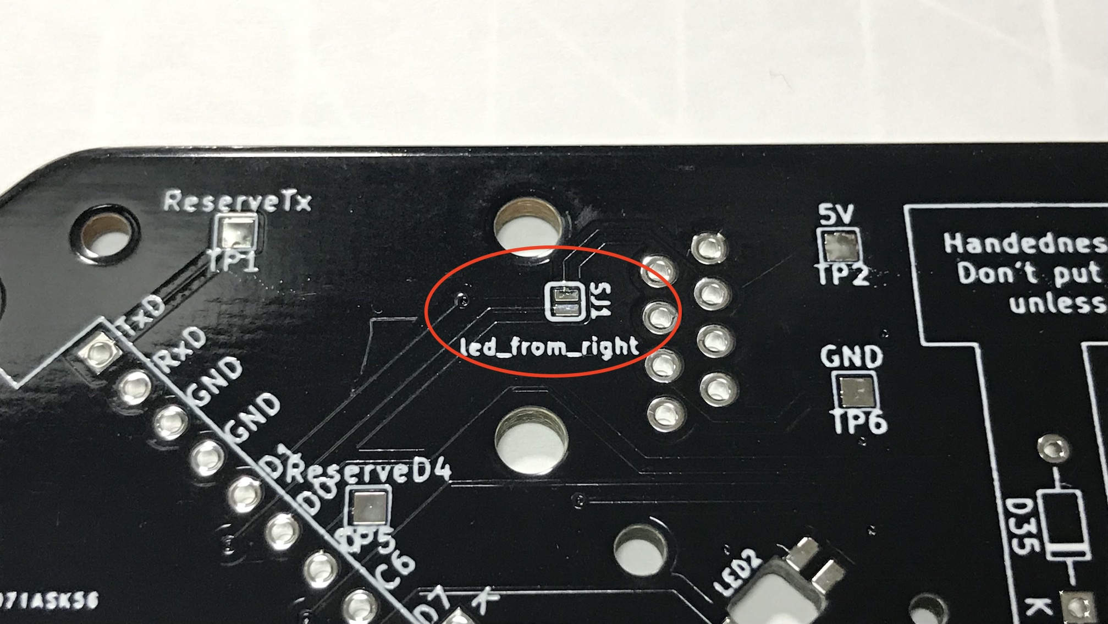
[picture p42: pictures/jumper_left_LED.jpg]
Jumper
<br>

## 7 ##
## 基板へのスペーサーのネジ止め ##
スペーサーを基板の裏面にネジで左右の基板それぞれ 13 箇所固定します（ネジをオモテ面に挿し、スペーサーが裏面にくるようにします）。<br>
キースイッチを半田付けした後にはネジを挿入することが難しい箇所があるため、キースイッチを半田付けする前に基板にネジを固定します。<br>
ただし、半田ごてがスペーサーに触れてしまうとスペーサーが溶けてしまうので、半田付けする際には十分ご注意ください。<br>

左手基板裏面<br>
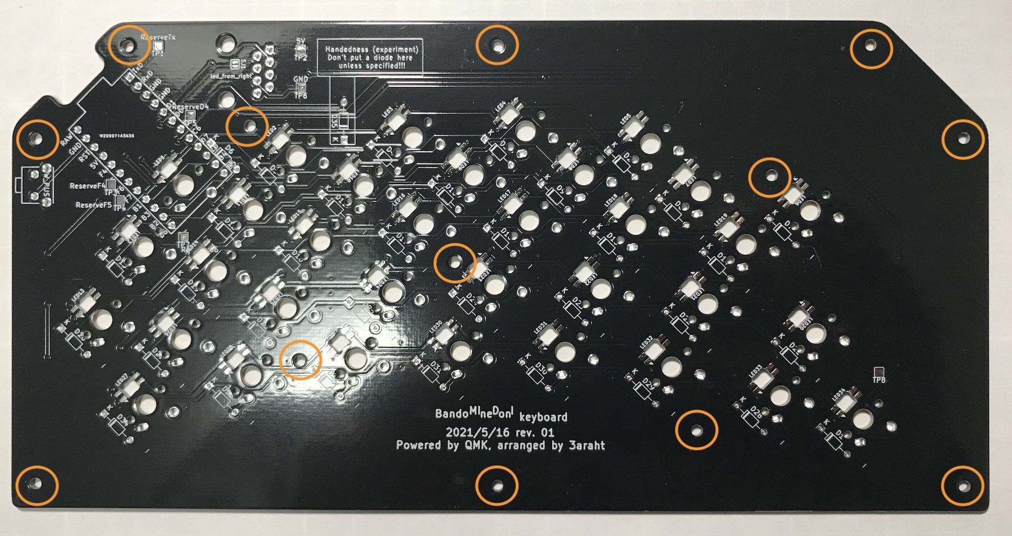
[picture p43: pictures/left_pcb_rear_r01_Spacer.jpg]
<br>

右手基板裏面<br>
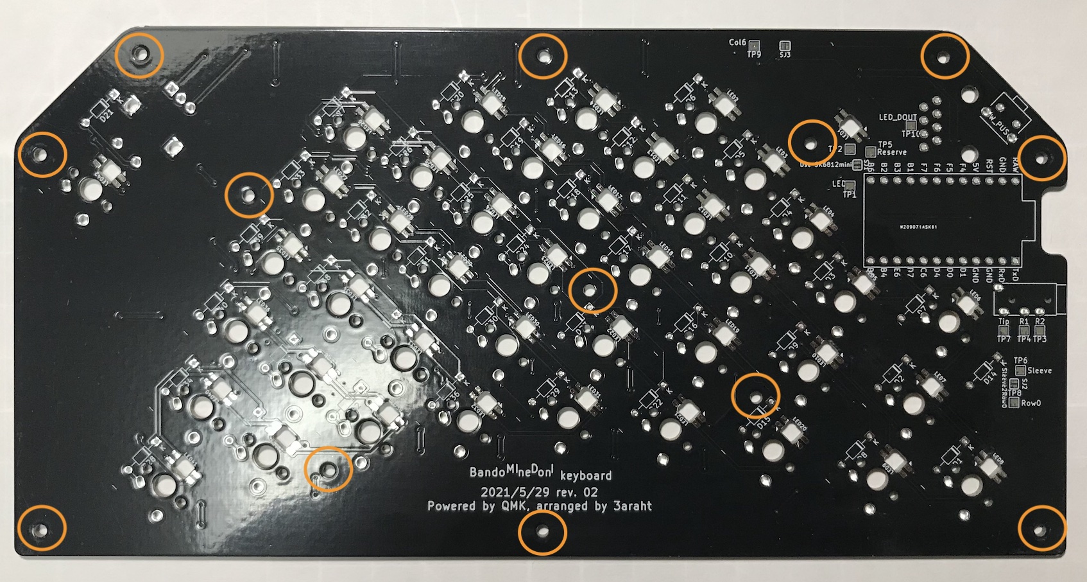
[picture p44: pictures/right_pcb_rear_r02_Spacer.jpg]
<br>

## 8 ##
## キースイッチの取付けと、エンコーダの取付け ##
**スイッチを取り付ける前に部品の取付けや半田付けができているか確認します。**<br>
（1 のダイオードは必ず済ませておいてください。）<br>

*動作確認する際には、①HEXファイル書き込み済の Pro Micro を実装し、②USBケーブルをPro Micro に挿して実施してください。**<br>
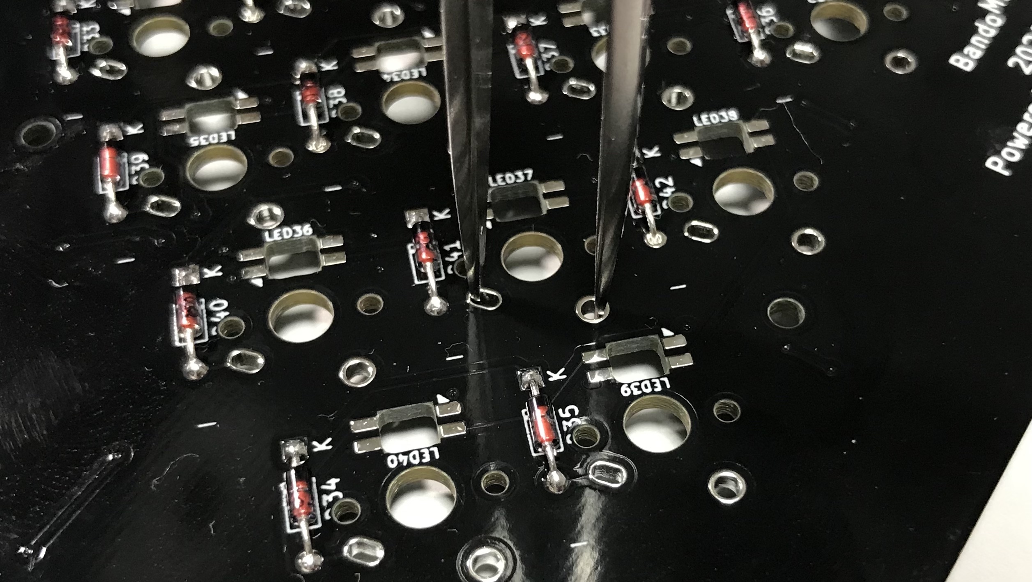
[picture p45: pictures/Keysw_test.jpg]


キースイッチをオモテ側からしっかり奥まで差し込みます。かなり固めですが、ピンが皆穴に入っていることに注意しながら押し込みます。このとき、端子が曲がっていると実装穴に端子が入らないので注意してください。1行ずつキースイッチをしっかり差し込んでから半田付けしていった方が差し込み不良は減らせると思います。<br>

ロータリーエンコーダーを実装します。<br>
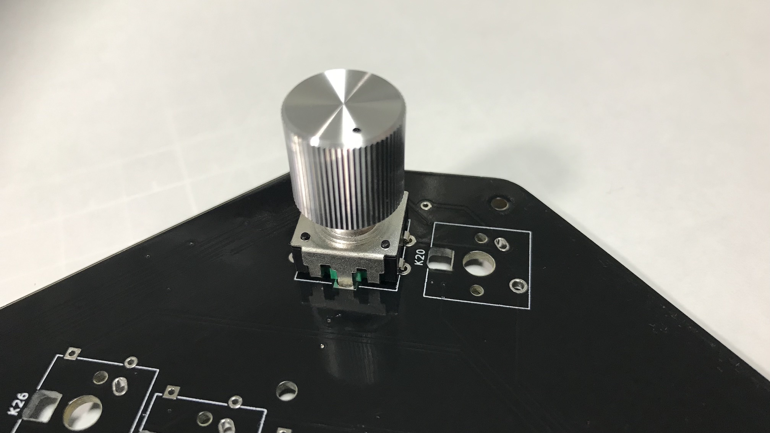
[picture p46: pictures/rotary_encoder_only.jpg]
RotaryEncorder


こちらは押しボタン機能の無いロータリーエンコーダー(EC12E24シリーズ)と、キースイッチを実装した場合です。
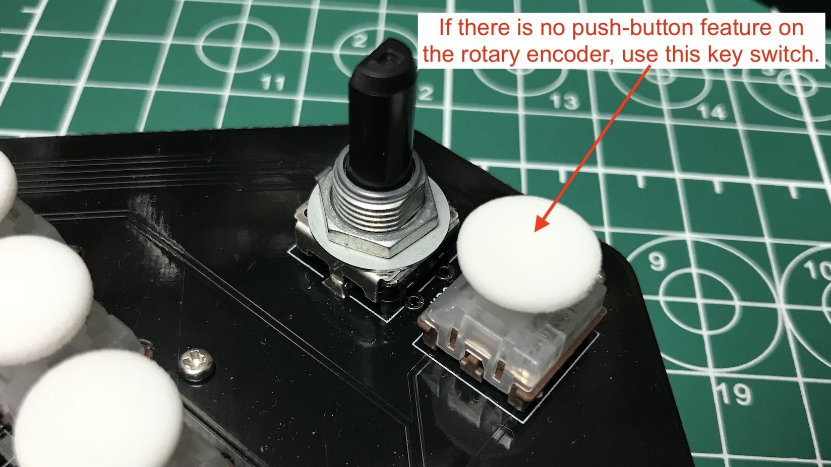
[picture p47: pictures/rotary_encorder_with_keyswitch.jpg]
RotaryEncorderWithoutPushButtonFuncWithKeyswitch


## 9 ##
## Firmwareの書き込み ##
5 で書き込みが完了していなかった場合にはここでファームウェアを書き込みます。

### 9.1 ###
### コーディングはちょっと自信がない／とりあえず動作させたい、という方 ###
[こちら](#5)を参考にファームウェアを書き込んでください。

### 9.2 ###
### コーディングに慣れている方、チャレンジされる方 ###

以下を参考に書き込んでください。または、QMKで検索すると書き込み方がすぐに出てくるはずです。<br>
https://docs.qmk.fm/#/getting_started_build_tools

bandoMIneDonI の Firmware は 2021/9/22、以下にUPされました！！！
https://github.com/qmk/qmk_firmware/tree/master/keyboards/bandominedoni

#### 9.2.1 ####
1. まず、qmk_firmware を clone してきます。
https://github.com/qmk/qmk_firmware

4. サスティン問題回避<br>
MIDIソフトによっては、同じ音を重ねて鳴らしたときにその音にUSBケーブルを抜き差しするまでサスティンがかかってしまう現象がありました。
~~対策方法がわかりましたので、それを適用します（こちらも pull request 中。正式に採用されるまでの暫定対策）。~~<br>
2020/10/5 pull request が メインブランチにマージされました。最新のソフトを clone いただければOKです。<br>
2021/04/13 残念ながら、2021/3/25 の process_midi.c の更新により、再びこの問題が復活しています。<br>
2023/09/23 以下の Pull Request から下記ファイルを取得し、`process_midi.c` を差し替えてください。

https://github.com/qmk/qmk_firmware/pull/22114
https://github.com/qmk/qmk_firmware/blob/e8906ed2ea0b9f20291b2759d4d65fc6c334ab39/quantum/process_keycode/process_midi.c

```
quantum/process_keycode/process_midi.c
```

##### 開閉ペダルの極性がノーマリオンタイプの場合 #####
デフォルトではノーマリオフタイプのペダルを想定していますが、ノーマリオンタイプ（ヤマハやローランド製のものなど）を使用する場合、
chromatonimini.h の 以下の1行をコメントアウトしてコンパイルしてください。
これにより、ノーマリオンタイプのペダルが使えるようになります。

```
#define PEDAL_NORMALLY_CLOSED
```

#### layers ####
REMAP さまさまですが、REMAPで生成したレイヤー情報は以下の通りです。

Layer<br>

Function(FN) Layer は、エンコーダボタン長押しで遷移します。<br>
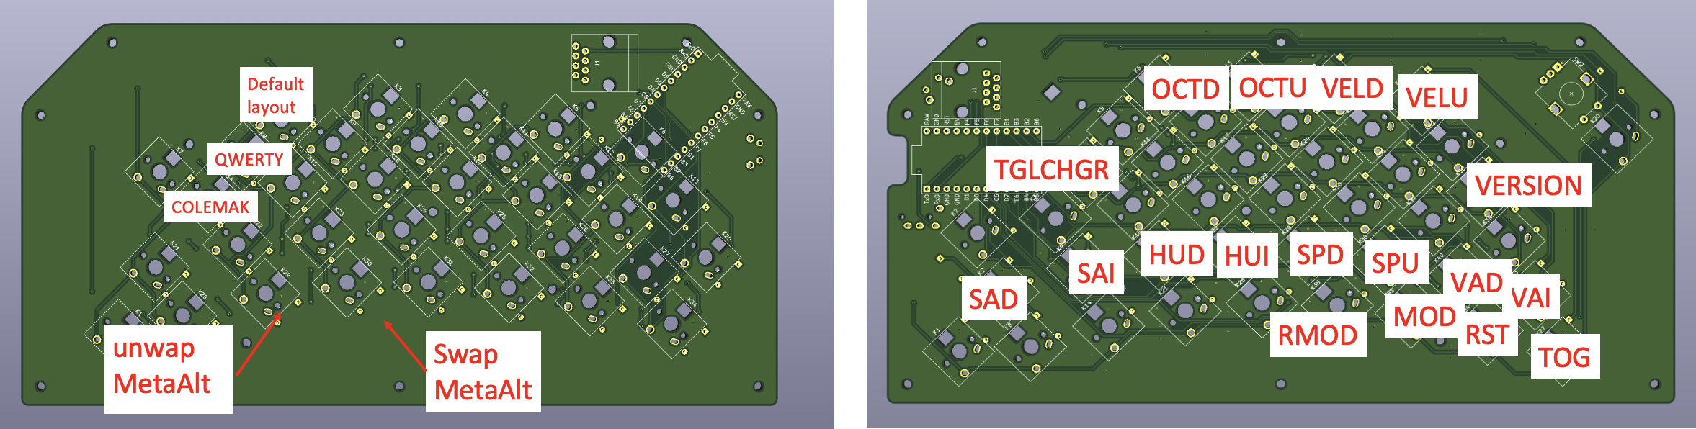
[picture p48: pictures/20240407_bandominedoni_FN_layer.png]
Layer
<br>

機能一覧
| ボタン名 |  機能  |  備考  |
|---|---|---|
|Default layout|基本のMIDIレイアウト||
|QWERTY|QWERTY 配列（タイピングキーボード）||
|COLEMAK|Colemak 配列（タイピングキーボード）||
|unswap MetaAlt|Meta と Alt キーをスワップしない|For Windows?|
|Swap MetaAlt|Meta と Alt キーをスワップ|For Mac?|
|OCTD|オクターブを下げる||
|OCTU|オクターブを上げる||
|VELD|ベロシティを下げる||
|VELU|ベロシティを上げる||
|TGLCHGR|TogGLe CHannel GRoup |デフォルトでは 右手側も左手側も Ch1。 このキーでモードをトグルすると、左手側は Ch2 に。|
|VERSION|ファームウェアバージョンを出力||
|SAD|Saturation down||
|SAI|Saturation up||
|HUD|Hue down||
|HUI|Hue up||
|SPD|Speed down||
|SPU|Speed up||
|VAD|Brightness down||
|VAU|Brightness up||
|RMOD|LED モードを逆周りに変更||
|MOD|LED モードを変更 ||
|RST|設定初期化||
|TOG|LED On Off の切り替え||

## 10 ##
## チェックポイント ##
簡単なチェック項目を挙げます。参考になれば幸いです。

【全体】
- Pro Micro はしっかり基板に刺さっている。
- Pro Micro のピンと基板のピンは一致させた状態で接続できている（Pro Micro の上下の向き確認）。
- USB ケーブルは通信可能なものを使っている（充電器の付属品などは要注意）。
- Pro Micro にファームウェアを書き込んである。
- MIDI機器に対応したソフトを起動している。
- 半田付けに問題はないか（ダイオードの向き、赤目、富士山、など）。

【Backlight RGB LED編】<br>
以下、チェック項目です。
- テスター（マルチメータ）をお持ちの場合は、基板からProMicro、ケーブル類を全て外した状態で、＋端子を5Vに、−端子をGND に当てて 抵抗測定してみてください。
  ~~もしも 1 MΩ以上の高抵抗値であれば正常。数十 kΩ程度かそれ以下の場合はLEDが一部破損 or LEDの向きが間違っている可能性があります。~~<br>
  嘘つきました。LED の 5V - GND 端子間の抵抗値が 100 kΩ 程度しか無いので、数十個の LED を並列繋ぎにしているため、抵抗値は 1 kΩ 程度しかありませんでした。<br>
  ⇨ 基板からProMicro、ケーブル類を全て外した状態で、テスターで 5V - GND 間の抵抗を測定して、1kΩ 未満ならどこかの LED がショート破損している可能性があります。 LED は並列接続されているので、どれが原因か特定するのが至難の技なのですが。。。
  それもあって、数珠繋ぎのLEDを順番に実装して光るか確認しながら進めることをおすすめします。

- LEDの向きが正しいか(切り欠きと三角マーク（GND）が同じ位置か確認)。
- 4つの端子が基板にしっかり半田付けできているか。数が多いので、数個半田が甘かった、ということはよくあります。
　特に、電源ラインのランドが大きくて熱を奪われるので、半田不良になりやすいです。十分ご注意ください。
- あるところから先の LED が全く光らない場合は、その境界のLEDの信号線で半田不良 or LED 破損の可能性があります。
  LED の並びについては、上記 2 Backlight RGB LEDの取付け[Optional] をご覧ください。
- あるところから先の LED の光り方が変な場合は、その境界の LED の電源線（5V か GND）の半田不良 or LED 破損の可能性があります。
- LED は光るものの、他のLEDに比べて暗い場合は、その LED が半田ごてに熱でやられている可能性があります。
- ボトムプレートをねじ止めしたら点灯していたはずのLEDが光らなくなった⇨半田不良の箇所が基板のたわみ方が変わった兼ね合いで端子が基板に接触しなくなった⇨半田ゴテで当たり直す。

また、遊舎工房さんの[サポートサイト](https://yushakobo.zendesk.com/hc/ja)が参考になると思います。併せてご覧ください。

## 11 ##
## ボトムプレートの組み立て ##
全てのキースイッチが正しく動作するのを確認したら、基板に取り付けたスペーサーにボトムプレートを固定します。
ボトムプレートの図の黄色丸の位置 13 箇所に M2 のねじでを挿入して固定します。<br>
ボトムプレートは、左右どちらの基板にも裏表を変えることで使用可能です。
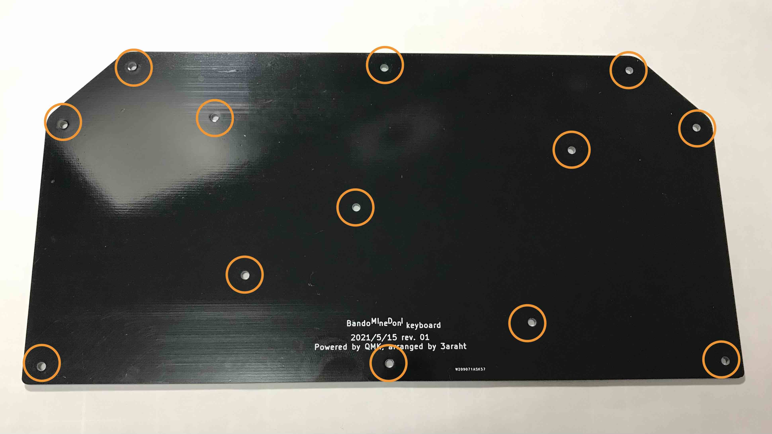
[picture p49: pictures/BottomPlate_r01_left.jpg]
<br>
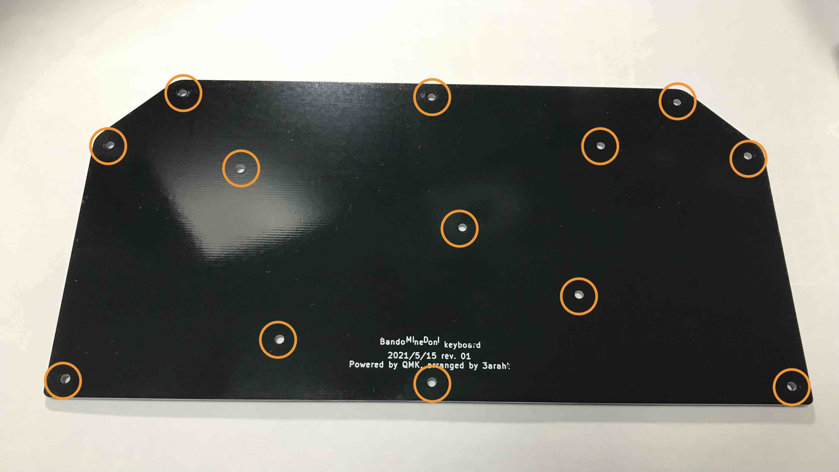
[picture p50: pictures/BottomPlate_r01_right.jpg]
<br>

ネジ止めは、たすき掛けで均一に締めつけますが、強く締めつけすぎないようにします。

左右それぞれ、黄色丸の位置 5 箇所にクッションシールを取り付けます。<br>
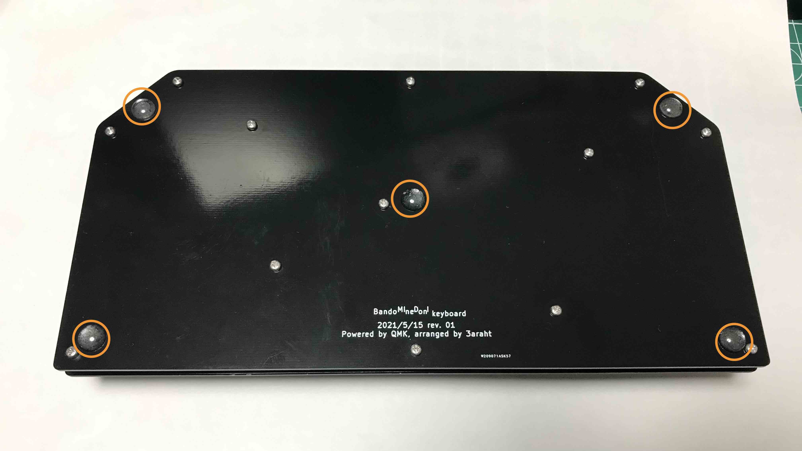
[picture p51: pictures/Cushion_r01_left.jpg]

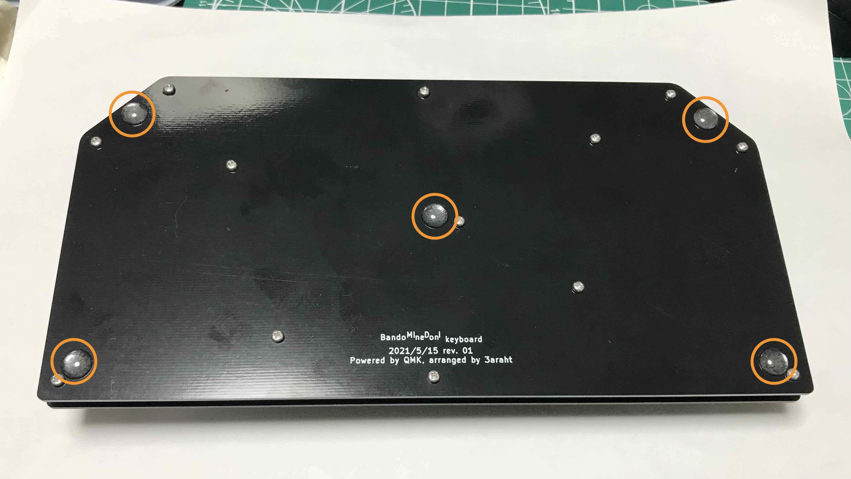
[picture p52: pictures/Cushion_r01_right.jpg]


#### お疲れ様でした。以上で bandoMIneDonI キーボードの完成です！
