3araht/bandominedoni/(commit log)

2021-06-09 LED tips added.
2021-11-24 Drashna's method is applied to rotary encoder rotation detection.
2022-07-18 Number of diodes & keyswitches needed are revised.
2022-07-30 left side diode soldering (D35) removed.
2022-08-08 VERSIOAN is available, lednotg keymap added.
2023-05-06 led on close version
